bhagwat-rahul/sg13cmos5l_rahulbhagwat_ip_pll_fractional_n_charge_pump_ring_osc/macros/inverter/testbenches/xschem/plot_simulations/figures/inverter_tb_dc_vout.csv

vin | vout | dvout_dvin
0.000000000000000000e+00 | 1.499998240000000038e+00 | -2.000000010049518551e-05
1.000000000000000021e-03 | 1.499998219999999938e+00 | -1.999999994950485416e-05
2.000000000000000042e-03 | 1.499998200000000059e+00 | -1.500000007581547834e-05
3.000000000000000062e-03 | 1.499998189999999898e+00 | -1.499999996212864062e-05
4.000000000000000083e-03 | 1.499998170000000020e+00 | -1.999999994950485416e-05
5.000000000000000104e-03 | 1.499998149999999919e+00 | -2.000000006319169188e-05
6.000000000000000125e-03 | 1.499998130000000041e+00 | -2.000000006319169188e-05
7.000000000000000146e-03 | 1.499998109999999940e+00 | -2.500000005056790542e-05
8.000000000000000167e-03 | 1.499998079999999900e+00 | -2.499999993688106770e-05
8.999999999999999320e-03 | 1.499998060000000022e+00 | -2.000000006319169188e-05
1.000000000000000021e-02 | 1.499998039999999921e+00 | -2.499999993688106770e-05
1.099999999999999936e-02 | 1.499998010000000104e+00 | -2.500000005056790542e-05
1.200000000000000025e-02 | 1.499997990000000003e+00 | -2.499999993688106770e-05
1.299999999999999940e-02 | 1.499997959999999964e+00 | -3.000000015163095668e-05
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
