bhagwat-rahul/sg13cmos5l_rahulbhagwat_ip_pll_fractional_n_charge_pump_ring_osc/final/netlist/slot_13.spice

* Slot13 assembly contract. Existing harness access points; no pad changes.
* reset is active LOW for this project; ibias0 supplies +2 uA into IREF.
* Unused accesses remain isolated. Direct terminals are not the _esd terminals.
.subckt slot_13 vbias
+ dig_in[23] dig_in[22] dig_in[21] dig_in[20] dig_in[19] dig_in[18]
+ dig_in[17] dig_in[16] dig_in[15] dig_in[14] dig_in[13] dig_in[12]
+ dig_in[11] dig_in[10] dig_in[9] dig_in[8] dig_in[7] dig_in[6]
+ dig_in[5] dig_in[4] dig_in[3] dig_in[2] dig_in[1] dig_in[0]
+ dig_out[11] dig_out[10] dig_out[9] dig_out[8] dig_out[7] dig_out[6]
+ dig_out[5] dig_out[4] dig_out[3] dig_out[2] dig_out[1] dig_out[0]
+ ibias0 ibias1 analog_bus3 analog_bus2 analog_bus1 analog_bus0
+ vss_1v2 vdd_1v2 vss_3v3 vdd_3v3 enable clk reset
+ s13_an_0_esd s13_an[0] s13_an_1_esd s13_an[1]
Xpll vdd_1v2 vss_1v2 ibias0 s13_an[0] reset enable
+ dig_in[0] dig_in[1] dig_in[2] dig_in[3] dig_in[4]
+ dig_in[5] dig_in[6] dig_in[7] dig_in[8] dig_in[9]
+ dig_in[10] dig_in[11] s13_an[1] pll_core
.ends slot_13

* Source-derived PLL core LVS reference; no extracted golden cells.
.subckt pll_core VDD VSS IREF ref_clk reset_n enable div_ratio[0] div_ratio[1] div_ratio[2] div_ratio[3] div_ratio[4] div_ratio[5] div_ratio[6] div_ratio[7] div_ratio[8] div_ratio[9] test_div_select[0] test_div_select[1] clk_out
Xanalog VDD up vco_clk down IREF VSS pll_analog
Xdigital VDD VSS ref_clk vco_clk reset_n enable div_ratio[0] div_ratio[1] div_ratio[2] div_ratio[3] div_ratio[4] div_ratio[5] div_ratio[6] div_ratio[7] div_ratio[8] div_ratio[9] test_div_select[0] test_div_select[1] feedback_unused pll_unused clk_out up down pll_digital
.ends pll_core
** sch_path: /foss/designs/current-designs/chipalooza2/sg13cmos5l_rahulbhagwat_ip_pll_fractional_n_charge_pump_ring_osc/layout/core/checks/pll_analog/20261022-053728-417796/schematic/pll_analog.sch
.subckt pll_analog VDD UP VCO_CLK DOWN IREF VSS
*.PININFO UP:I DOWN:I IREF:B VCO_CLK:O VDD:B VSS:B
x_charge_pump VDD UP DOWN IREF VCTRL VSS charge_pump
x_loop_filter VCTRL VSS loop_filter
x_vco VDD VCO_CLK VCTRL VSS ring_oscillator
.ends

* expanding   symbol:  charge_pump.sym # of pins=6
** sym_path: /foss/designs/current-designs/chipalooza2/sg13cmos5l_rahulbhagwat_ip_pll_fractional_n_charge_pump_ring_osc/layout/core/checks/pll_analog/20261022-053728-417796/schematic/charge_pump.sym
** sch_path: /foss/designs/current-designs/chipalooza2/sg13cmos5l_rahulbhagwat_ip_pll_fractional_n_charge_pump_ring_osc/layout/core/checks/pll_analog/20261022-053728-417796/schematic/charge_pump.sch
.subckt charge_pump VDD UP DOWN IREF VCTRL VSS
*.PININFO UP:I DOWN:I IREF:B VCTRL:O VDD:B VSS:B
XM_UP_INV_P UP_B UP VDD VDD sg13_lv_pmos w=0.30u l=0.13u ng=1 m=1
XM_UP_INV_N UP_B UP VSS VSS sg13_lv_nmos w=0.15u l=0.13u ng=1 m=1
XM_IREF IREF IREF VSS VSS sg13_lv_nmos w=4.0u l=0.50u ng=4 m=1
XM_PBIAS PBIAS PBIAS VDD VDD sg13_lv_pmos w=8.0u l=0.50u ng=8 m=1
XM_PBIAS_SINK PBIAS IREF VSS VSS sg13_lv_nmos w=4.0u l=0.50u ng=4 m=1
XM_UP_SOURCE P_UP PBIAS VDD VDD sg13_lv_pmos w=7.0u l=0.50u ng=8 m=1
XM_UP_SWITCH VCTRL UP_B P_UP VDD sg13_lv_pmos w=1.0u l=0.13u ng=1 m=1
XM_DOWN_SWITCH VCTRL DOWN N_DOWN VSS sg13_lv_nmos w=1.5u l=0.13u ng=1 m=1
XM_DOWN_SINK N_DOWN IREF VSS VSS sg13_lv_nmos w=4.0u l=0.50u ng=4 m=1
.ends


* expanding   symbol:  loop_filter.sym # of pins=2
** sym_path: /foss/designs/current-designs/chipalooza2/sg13cmos5l_rahulbhagwat_ip_pll_fractional_n_charge_pump_ring_osc/layout/core/checks/pll_analog/20261022-053728-417796/schematic/loop_filter.sym
** sch_path: /foss/designs/current-designs/chipalooza2/sg13cmos5l_rahulbhagwat_ip_pll_fractional_n_charge_pump_ring_osc/layout/core/checks/pll_analog/20261022-053728-417796/schematic/loop_filter.sch
.subckt loop_filter VCTRL VSS
*.PININFO VCTRL:B VSS:B
XR1 VCTRL FILTER_ZERO VSS rhigh w=1.0u l=22.08u m=1 b=0
XC1A FILTER_ZERO VSS cap_cmomf w=100u l=100u mmin=2 mmax=4 subblock=0 m=1
XC2 VCTRL VSS cap_cmomf w=32.6431u l=32.6431u mmin=2 mmax=4 subblock=0 m=1
**** begin user architecture code



* Simulator model supplied by the PDK LVS setup
* Simulator model supplied by the PDK LVS setup


**** end user architecture code
.ends


* expanding   symbol:  ring_oscillator.sym # of pins=4
** sym_path: /foss/designs/current-designs/chipalooza2/sg13cmos5l_rahulbhagwat_ip_pll_fractional_n_charge_pump_ring_osc/layout/core/checks/pll_analog/20261022-053728-417796/schematic/ring_oscillator.sym
** sch_path: /foss/designs/current-designs/chipalooza2/sg13cmos5l_rahulbhagwat_ip_pll_fractional_n_charge_pump_ring_osc/layout/core/checks/pll_analog/20261022-053728-417796/schematic/ring_oscillator.sch
.subckt ring_oscillator VDD VCO_OUT VCTRL VSS
*.PININFO VCTRL:I VDD:B VSS:B VCO_OUT:O
x1 VDD VBP VCO_CORE net1 VCTRL VSS inverter
x2 VDD VBP net1 net2 VCTRL VSS inverter
x3 VDD VBP net2 VCO_CORE VCTRL VSS inverter
x_bias VDD VBP VCTRL VSS vco_bias
x_buffer VDD VCO_CORE VCO_OUT VSS vco_buffer
.ends


* expanding   symbol:  inverter.sym # of pins=6
** sym_path: /foss/designs/current-designs/chipalooza2/sg13cmos5l_rahulbhagwat_ip_pll_fractional_n_charge_pump_ring_osc/layout/core/checks/pll_analog/20261022-053728-417796/schematic/inverter.sym
** sch_path: /foss/designs/current-designs/chipalooza2/sg13cmos5l_rahulbhagwat_ip_pll_fractional_n_charge_pump_ring_osc/layout/core/checks/pll_analog/20261022-053728-417796/schematic/inverter.sch
.subckt inverter VDD VBP VIN VOUT VBN VSS
*.PININFO VIN:I VBP:I VBN:I VOUT:O VDD:B VSS:B
XM1 net1 VBP VDD VDD sg13_lv_pmos w=18.0u l=0.13u ng=5 m=1
XM2 VOUT VIN net1 VDD sg13_lv_pmos w=3.6u l=0.13u ng=1 m=1
XM3 VOUT VIN net2 VSS sg13_lv_nmos w=3.6u l=0.13u ng=1 m=1
XM4 net2 VBN VSS VSS sg13_lv_nmos w=18.0u l=0.13u ng=5 m=1
.ends


* expanding   symbol:  vco_bias.sym # of pins=4
** sym_path: /foss/designs/current-designs/chipalooza2/sg13cmos5l_rahulbhagwat_ip_pll_fractional_n_charge_pump_ring_osc/layout/core/checks/pll_analog/20261022-053728-417796/schematic/vco_bias.sym
** sch_path: /foss/designs/current-designs/chipalooza2/sg13cmos5l_rahulbhagwat_ip_pll_fractional_n_charge_pump_ring_osc/layout/core/checks/pll_analog/20261022-053728-417796/schematic/vco_bias.sch
.subckt vco_bias VDD VBP VCTRL VSS
*.PININFO VCTRL:I VBP:O VDD:B VSS:B
XM1 VBP VBP VDD VDD sg13_lv_pmos w=0.15u l=0.13u ng=1 m=1
XM2 VBP VCTRL VSS VSS sg13_lv_nmos w=0.15u l=0.13u ng=1 m=1
.ends


* expanding   symbol:  vco_buffer.sym # of pins=4
** sym_path: /foss/designs/current-designs/chipalooza2/sg13cmos5l_rahulbhagwat_ip_pll_fractional_n_charge_pump_ring_osc/layout/core/checks/pll_analog/20261022-053728-417796/schematic/vco_buffer.sym
** sch_path: /foss/designs/current-designs/chipalooza2/sg13cmos5l_rahulbhagwat_ip_pll_fractional_n_charge_pump_ring_osc/layout/core/checks/pll_analog/20261022-053728-417796/schematic/vco_buffer.sch
.subckt vco_buffer VDD VIN VOUT VSS
*.PININFO VIN:I VOUT:O VDD:B VSS:B
XM1 net1 VIN VDD VDD sg13_lv_pmos w=2.40u l=0.13u ng=1 m=1
XM2 net1 VIN VSS VSS sg13_lv_nmos w=1.80u l=0.13u ng=1 m=1
XM3 VOUT net1 VDD VDD sg13_lv_pmos w=1.80u l=0.13u ng=3 m=1
XM4 VOUT net1 VSS VSS sg13_lv_nmos w=0.90u l=0.13u ng=3 m=1
.ends


.subckt pll_digital VDD VSS ref_clk vco_clk reset_n enable div_ratio[0] div_ratio[1] div_ratio[2] div_ratio[3] div_ratio[4] div_ratio[5] div_ratio[6] div_ratio[7] div_ratio[8] div_ratio[9] test_div_select[0] test_div_select[1] feedback_clk pll_clk test_clk up down
* SPICE netlist generated by Yosys 0.68 (git sha1 38e001a6f, Release, GNU /usr/bin/c++ 13.3.0)

X0 VDD VSS sg13cmos5l_decap_8
X1 VDD VSS sg13cmos5l_decap_8
X2 VDD VSS sg13cmos5l_decap_4
X3 VDD VSS sg13cmos5l_decap_8
X4 VDD VSS sg13cmos5l_decap_8
X5 VDD VSS sg13cmos5l_decap_4
X6 VDD VSS sg13cmos5l_decap_8
X7 VDD VSS sg13cmos5l_decap_8
X8 VDD VSS sg13cmos5l_decap_8
X9 VDD VSS sg13cmos5l_decap_8
X10 VDD VSS sg13cmos5l_decap_8
X11 VDD VSS sg13cmos5l_decap_8
X12 VDD VSS sg13cmos5l_decap_8
X13 VDD VSS sg13cmos5l_decap_8
X14 VDD VSS sg13cmos5l_decap_8
X15 VDD VSS sg13cmos5l_fill_2
X16 VDD VSS sg13cmos5l_decap_8
X17 VDD VSS sg13cmos5l_decap_8
X18 VDD VSS sg13cmos5l_fill_1
X19 VDD VSS sg13cmos5l_fill_1
X20 VDD VSS sg13cmos5l_decap_8
X21 VDD VSS sg13cmos5l_decap_8
X22 VDD VSS sg13cmos5l_fill_2
X23 VDD VSS sg13cmos5l_decap_4
X24 VDD VSS sg13cmos5l_decap_8
X25 VDD VSS sg13cmos5l_decap_8
X26 VDD VSS sg13cmos5l_fill_2
X27 VDD VSS sg13cmos5l_fill_1
X28 VDD VSS sg13cmos5l_decap_8
X29 VDD VSS sg13cmos5l_decap_8
X30 VDD VSS sg13cmos5l_decap_4
X31 VDD VSS sg13cmos5l_decap_4
X32 VDD VSS sg13cmos5l_fill_1
X33 VDD VSS sg13cmos5l_fill_1
X34 VDD VSS sg13cmos5l_fill_2
X35 VDD VSS sg13cmos5l_fill_1
X36 VDD VSS sg13cmos5l_decap_4
X37 VDD VSS sg13cmos5l_decap_4
X38 VDD VSS sg13cmos5l_decap_8
X39 VDD VSS sg13cmos5l_decap_4
X40 VDD VSS sg13cmos5l_fill_2
X41 VDD VSS sg13cmos5l_decap_8
X42 VDD VSS sg13cmos5l_decap_8
X43 VDD VSS sg13cmos5l_decap_8
X44 VDD VSS sg13cmos5l_decap_8
X45 VDD VSS sg13cmos5l_decap_4
X46 VDD VSS sg13cmos5l_fill_1
X47 VDD VSS sg13cmos5l_fill_2
X48 VDD VSS sg13cmos5l_fill_2
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
X705 clknet_0_output_divider_i.div4_clk_regs output_divider_i.div4_clk_regs VDD VSS sg13cmos5l_buf_16
X706 clknet_0_output_divider_i.div8_clk output_divider_i.div8_clk VDD VSS sg13cmos5l_buf_16
X707 clknet_0_output_divider_i.div8_clk_regs output_divider_i.div8_clk_regs VDD VSS sg13cmos5l_buf_16
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
