bhagwat-rahul/sg13cmos5l_rahulbhagwat_ip_pll_fractional_n_charge_pump_ring_osc/netlist/layout/sg13cmos5l_chipalooza_analog_project_klayout.cir

* Extracted by KLayout with SG13CMOS5L LVS runset on : 26/08/2026 18:47

.SUBCKT sg13cmos5l_chipalooza_analog_project VAPWR VGND VPWR analog_0 analog_1
+ analog_2 ui_in[0]
X$14 VGND VAPWR analog_2 ui_in[0] inverter
X$15 VGND VAPWR analog_1 analog_0 inverter
M$1 VGND VPWR VGND VGND sg13_lv_pmos L=10u W=10u AS=3.4p AD=3.4p PS=20.68u
+ PD=20.68u rfmode=0
M$2 VGND VAPWR VGND VGND sg13_lv_pmos L=10u W=10u AS=3.4p AD=3.4p PS=20.68u
+ PD=20.68u rfmode=0
.ENDS sg13cmos5l_chipalooza_analog_project

.SUBCKT inverter VSS VDD vout vin
M$1 VSS VSS VSS VSS sg13_lv_nmos L=1u W=2u AS=0.53p AD=0.53p PS=4.06u PD=4.06u
+ rfmode=0
M$2 VSS vin vout VSS sg13_lv_nmos L=1u W=20u AS=3.8p AD=3.8p PS=27.6u PD=27.6u
+ rfmode=0
M$23 VDD VDD VDD VDD sg13_lv_pmos L=1u W=12u AS=3.18p AD=3.18p PS=19.06u
+ PD=19.06u rfmode=0
M$24 VDD vin vout VDD sg13_lv_pmos L=1u W=120u AS=22.8p AD=22.8p PS=127.6u
+ PD=127.6u rfmode=0
.ENDS inverter
