bhagwat-rahul/sg13cmos5l_rahulbhagwat_ip_pll_fractional_n_charge_pump_ring_osc/netlist/pex/sg13cmos5l_chipalooza_analog_project_magic_pex_3.spice

* PEX produced on Wed Aug 26 06:47:14 PM CEST 2026 using /foss/tools/sak/sak-pex.sh with m=3 and s=1 (extresist threshold=10000 mOhm, minres=1000 mOhm, mindelay=1 ps)
* NGSPICE file created from sg13cmos5l_chipalooza_analog_project_pex.ext - technology: ihp-sg13cmos5l

.subckt sg13cmos5l_chipalooza_analog_project_pex VPWR VAPWR VGND rst_n clk ena
+ uio_in[7] uio_in[6] uio_in[5] uio_in[4] uio_in[3] uio_in[2] uio_in[1]
+ uio_in[0] ui_in[7] ui_in[6] ui_in[5] ui_in[4] ui_in[3] ui_in[2] ui_in[1]
+ ui_in[0] uio_oe[7] uio_oe[6] uio_oe[5] uio_oe[4] uio_oe[3] uio_oe[2] uio_oe[1]
+ uio_oe[0] uio_out[7] uio_out[6] uio_out[5] uio_out[4] uio_out[3] uio_out[2]
+ uio_out[1] uio_out[0] uo_out[7] uo_out[6] uo_out[5] uo_out[4] uo_out[3]
+ uo_out[2] uo_out[1] uo_out[0] analog_2 analog_1 analog_0
X0 VAPWR VAPWR VAPWR VAPWR sg13_lv_pmos ad=1.14p pd=6.38u as=0.28875n ps=0.61464m w=6u l=1u
X1 VGND.t55 VGND.t53 VGND.t31 VGND.t54 sg13_lv_nmos ad=0.34p pd=2.68u as=0 ps=0 w=1u l=1u
X2 analog_1 analog_0 VGND.t1 VGND.t0 sg13_lv_nmos ad=0.19p pd=1.38u as=0.19p ps=1.38u w=1u l=1u
X3 analog_1 analog_0 VAPWR VAPWR sg13_lv_pmos ad=1.14p pd=6.38u as=1.14p ps=6.38u w=6u l=1u
X4 VAPWR ui_in[0].t1 analog_2 VAPWR sg13_lv_pmos ad=1.14p pd=6.38u as=1.14p ps=6.38u w=6u l=1u
X5 VAPWR analog_0 analog_1 VAPWR sg13_lv_pmos ad=1.14p pd=6.38u as=1.14p ps=6.38u w=6u l=1u
X6 analog_1 analog_0 VGND.t3 VGND.t4 sg13_lv_nmos ad=0.19p pd=1.38u as=0.19p ps=1.38u w=1u l=1u
X7 VAPWR analog_0 analog_1 VAPWR sg13_lv_pmos ad=1.14p pd=6.38u as=1.14p ps=6.38u w=6u l=1u
X8 VAPWR analog_0 analog_1 VAPWR sg13_lv_pmos ad=1.14p pd=6.38u as=1.14p ps=6.38u w=6u l=1u
X9 VGND.t9 analog_0 analog_1 VGND.t8 sg13_lv_nmos ad=0.19p pd=1.38u as=0.19p ps=1.38u w=1u l=1u
X10 VAPWR analog_0 analog_1 VAPWR sg13_lv_pmos ad=1.14p pd=6.38u as=1.14p ps=6.38u w=6u l=1u
X11 analog_1 analog_0 VAPWR VAPWR sg13_lv_pmos ad=1.14p pd=6.38u as=1.14p ps=6.38u w=6u l=1u
X12 analog_2 ui_in[0].t1 VAPWR VAPWR sg13_lv_pmos ad=1.14p pd=6.38u as=1.14p ps=6.38u w=6u l=1u
X13 VGND.t6 analog_0 analog_1 VGND.t5 sg13_lv_nmos ad=0.19p pd=1.38u as=0.19p ps=1.38u w=1u l=1u
X14 VGND.t12 analog_0 analog_1 VGND.t11 sg13_lv_nmos ad=0.19p pd=1.38u as=0.19p ps=1.38u w=1u l=1u
X15 analog_1 analog_0 VAPWR VAPWR sg13_lv_pmos ad=1.14p pd=6.38u as=1.14p ps=6.38u w=6u l=1u
X16 analog_2 ui_in[0].t1 VAPWR VAPWR sg13_lv_pmos ad=1.14p pd=6.38u as=1.14p ps=6.38u w=6u l=1u
X17 VAPWR analog_0 analog_1 VAPWR sg13_lv_pmos ad=1.14p pd=6.38u as=1.14p ps=6.38u w=6u l=1u
X18 VAPWR ui_in[0].t1 analog_2 VAPWR sg13_lv_pmos ad=1.14p pd=6.38u as=1.14p ps=6.38u w=6u l=1u
X19 VGND.t15 analog_0 analog_1 VGND.t14 sg13_lv_nmos ad=0.19p pd=1.38u as=0.19p ps=1.38u w=1u l=1u
X20 analog_1 analog_0 VGND.t21 VGND.t22 sg13_lv_nmos ad=0.19p pd=1.38u as=0.19p ps=1.38u w=1u l=1u
X21 analog_2 ui_in[0].t1 VAPWR VAPWR sg13_lv_pmos ad=1.14p pd=6.38u as=1.14p ps=6.38u w=6u l=1u
X22 VGND.t50 ui_in[0].t0 analog_2 VGND.t29 sg13_lv_nmos ad=0.19p pd=1.38u as=0.19p ps=1.38u w=1u l=1u
X23 analog_1 analog_0 VGND.t18 VGND.t19 sg13_lv_nmos ad=0.19p pd=1.38u as=0.19p ps=1.38u w=1u l=1u
X24 VAPWR analog_0 analog_1 VAPWR sg13_lv_pmos ad=1.14p pd=6.38u as=1.14p ps=6.38u w=6u l=1u
X25 VAPWR ui_in[0].t1 analog_2 VAPWR sg13_lv_pmos ad=1.14p pd=6.38u as=1.14p ps=6.38u w=6u l=1u
X26 analog_2 ui_in[0].t1 VAPWR VAPWR sg13_lv_pmos ad=1.14p pd=6.38u as=1.14p ps=6.38u w=6u l=1u
X27 analog_2 ui_in[0].t0 VGND.t31 VGND.t0 sg13_lv_nmos ad=0.19p pd=1.38u as=0.19p ps=1.38u w=1u l=1u
X28 VGND.t24 analog_0 analog_1 VGND.t23 sg13_lv_nmos ad=0.19p pd=1.38u as=0.19p ps=1.38u w=1u l=1u
X29 VAPWR VAPWR VAPWR VAPWR sg13_lv_pmos ad=1.14p pd=6.38u as=0 ps=0 w=6u l=1u
X30 analog_2 ui_in[0].t1 VAPWR VAPWR sg13_lv_pmos ad=1.14p pd=6.38u as=1.14p ps=6.38u w=6u l=1u
X31 analog_2 ui_in[0].t1 VAPWR VAPWR sg13_lv_pmos ad=1.14p pd=6.38u as=1.14p ps=6.38u w=6u l=1u
X32 VAPWR VAPWR VAPWR VAPWR sg13_lv_pmos ad=2.04p pd=12.68u as=0 ps=0 w=6u l=1u
X33 VGND.t27 analog_0 analog_1 VGND.t26 sg13_lv_nmos ad=0.19p pd=1.38u as=0.19p ps=1.38u w=1u l=1u
X34 VAPWR analog_0 analog_1 VAPWR sg13_lv_pmos ad=1.14p pd=6.38u as=1.14p ps=6.38u w=6u l=1u
X35 analog_2 ui_in[0].t0 VGND.t32 VGND.t4 sg13_lv_nmos ad=0.19p pd=1.38u as=0.19p ps=1.38u w=1u l=1u
X36 VGND.t30 VGND.t62 VGND.t63 VGND.t57 sg13_lv_nmos ad=0.19p pd=1.38u as=0 ps=0 w=1u l=1u
X37 VGND.t52 VPWR VGND.t52 VGND.t51 sg13_lv_pmos ad=3.4p pd=20.68u as=0 ps=0 w=10u l=10u
X38 VGND.t36 ui_in[0].t0 analog_2 VGND.t8 sg13_lv_nmos ad=0.19p pd=1.38u as=0.19p ps=1.38u w=1u l=1u
X39 VGND.t3 analog_0 analog_1 VGND.t2 sg13_lv_nmos ad=0.19p pd=1.38u as=0.19p ps=1.38u w=1u l=1u
X40 VGND.t34 ui_in[0].t0 analog_2 VGND.t5 sg13_lv_nmos ad=0.19p pd=1.38u as=0.19p ps=1.38u w=1u l=1u
X41 VGND.t38 ui_in[0].t0 analog_2 VGND.t11 sg13_lv_nmos ad=0.19p pd=1.38u as=0.19p ps=1.38u w=1u l=1u
X42 analog_1 analog_0 VAPWR VAPWR sg13_lv_pmos ad=1.14p pd=6.38u as=1.14p ps=6.38u w=6u l=1u
X43 analog_1 analog_0 VAPWR VAPWR sg13_lv_pmos ad=1.14p pd=6.38u as=1.14p ps=6.38u w=6u l=1u
X44 VGND.t40 ui_in[0].t0 analog_2 VGND.t14 sg13_lv_nmos ad=0.19p pd=1.38u as=0.19p ps=1.38u w=1u l=1u
X45 analog_2 ui_in[0].t0 VGND.t44 VGND.t22 sg13_lv_nmos ad=0.19p pd=1.38u as=0.19p ps=1.38u w=1u l=1u
X46 analog_1 analog_0 VGND.t9 VGND.t10 sg13_lv_nmos ad=0.19p pd=1.38u as=0.19p ps=1.38u w=1u l=1u
X47 VAPWR analog_0 analog_1 VAPWR sg13_lv_pmos ad=1.14p pd=6.38u as=1.14p ps=6.38u w=6u l=1u
X48 analog_2 ui_in[0].t0 VGND.t42 VGND.t19 sg13_lv_nmos ad=0.19p pd=1.38u as=0.19p ps=1.38u w=1u l=1u
X49 analog_1 analog_0 VAPWR VAPWR sg13_lv_pmos ad=1.14p pd=6.38u as=1.14p ps=6.38u w=6u l=1u
X50 VGND.t46 ui_in[0].t0 analog_2 VGND.t23 sg13_lv_nmos ad=0.19p pd=1.38u as=0.19p ps=1.38u w=1u l=1u
X51 analog_1 analog_0 VGND.t12 VGND.t13 sg13_lv_nmos ad=0.19p pd=1.38u as=0.19p ps=1.38u w=1u l=1u
X52 VAPWR analog_0 analog_1 VAPWR sg13_lv_pmos ad=1.14p pd=6.38u as=1.14p ps=6.38u w=6u l=1u
X53 analog_1 analog_0 VAPWR VAPWR sg13_lv_pmos ad=1.14p pd=6.38u as=1.14p ps=6.38u w=6u l=1u
X54 VAPWR ui_in[0].t1 analog_2 VAPWR sg13_lv_pmos ad=1.14p pd=6.38u as=1.14p ps=6.38u w=6u l=1u
X55 VGND.t18 analog_0 analog_1 VGND.t17 sg13_lv_nmos ad=0.19p pd=1.38u as=0.19p ps=1.38u w=1u l=1u
X56 analog_1 analog_0 VAPWR VAPWR sg13_lv_pmos ad=1.14p pd=6.38u as=1.14p ps=6.38u w=6u l=1u
X57 analog_1 analog_0 VAPWR VAPWR sg13_lv_pmos ad=1.14p pd=6.38u as=1.14p ps=6.38u w=6u l=1u
X58 analog_2 ui_in[0].t1 VAPWR VAPWR sg13_lv_pmos ad=1.14p pd=6.38u as=1.14p ps=6.38u w=6u l=1u
X59 VGND.t48 ui_in[0].t0 analog_2 VGND.t26 sg13_lv_nmos ad=0.19p pd=1.38u as=0.19p ps=1.38u w=1u l=1u
X60 analog_1 analog_0 VGND.t15 VGND.t16 sg13_lv_nmos ad=0.19p pd=1.38u as=0.19p ps=1.38u w=1u l=1u
X61 VAPWR VAPWR VAPWR VAPWR sg13_lv_pmos ad=2.04p pd=12.68u as=0 ps=0 w=6u l=1u
X62 VGND.t50 VGND.t56 VGND.t58 VGND.t57 sg13_lv_nmos ad=0.19p pd=1.38u as=0 ps=0 w=1u l=1u
X63 VGND.t21 analog_0 analog_1 VGND.t20 sg13_lv_nmos ad=0.19p pd=1.38u as=0.19p ps=1.38u w=1u l=1u
X64 analog_1 analog_0 VGND.t27 VGND.t28 sg13_lv_nmos ad=0.19p pd=1.38u as=0.19p ps=1.38u w=1u l=1u
X65 VGND.t61 VGND.t59 VGND.t1 VGND.t54 sg13_lv_nmos ad=0.34p pd=2.68u as=0 ps=0 w=1u l=1u
X66 analog_1 analog_0 VGND.t6 VGND.t7 sg13_lv_nmos ad=0.19p pd=1.38u as=0.19p ps=1.38u w=1u l=1u
X67 analog_1 analog_0 VGND.t24 VGND.t25 sg13_lv_nmos ad=0.19p pd=1.38u as=0.19p ps=1.38u w=1u l=1u
X68 analog_2 ui_in[0].t1 VAPWR VAPWR sg13_lv_pmos ad=1.14p pd=6.38u as=1.14p ps=6.38u w=6u l=1u
X69 VAPWR ui_in[0].t1 analog_2 VAPWR sg13_lv_pmos ad=1.14p pd=6.38u as=1.14p ps=6.38u w=6u l=1u
X70 VGND.t32 ui_in[0].t0 analog_2 VGND.t2 sg13_lv_nmos ad=0.19p pd=1.38u as=0.19p ps=1.38u w=1u l=1u
X71 VAPWR ui_in[0].t1 analog_2 VAPWR sg13_lv_pmos ad=1.14p pd=6.38u as=1.14p ps=6.38u w=6u l=1u
X72 VAPWR ui_in[0].t1 analog_2 VAPWR sg13_lv_pmos ad=1.14p pd=6.38u as=1.14p ps=6.38u w=6u l=1u
X73 analog_2 ui_in[0].t0 VGND.t36 VGND.t10 sg13_lv_nmos ad=0.19p pd=1.38u as=0.19p ps=1.38u w=1u l=1u
X74 VAPWR ui_in[0].t1 analog_2 VAPWR sg13_lv_pmos ad=1.14p pd=6.38u as=1.14p ps=6.38u w=6u l=1u
X75 analog_2 ui_in[0].t1 VAPWR VAPWR sg13_lv_pmos ad=1.14p pd=6.38u as=1.14p ps=6.38u w=6u l=1u
X76 analog_2 ui_in[0].t0 VGND.t38 VGND.t13 sg13_lv_nmos ad=0.19p pd=1.38u as=0.19p ps=1.38u w=1u l=1u
X77 analog_2 ui_in[0].t1 VAPWR VAPWR sg13_lv_pmos ad=1.14p pd=6.38u as=1.14p ps=6.38u w=6u l=1u
X78 VGND.t42 ui_in[0].t0 analog_2 VGND.t17 sg13_lv_nmos ad=0.19p pd=1.38u as=0.19p ps=1.38u w=1u l=1u
X79 VAPWR analog_0 analog_1 VAPWR sg13_lv_pmos ad=1.14p pd=6.38u as=1.14p ps=6.38u w=6u l=1u
X80 VAPWR ui_in[0].t1 analog_2 VAPWR sg13_lv_pmos ad=1.14p pd=6.38u as=1.14p ps=6.38u w=6u l=1u
X81 analog_2 ui_in[0].t0 VGND.t40 VGND.t16 sg13_lv_nmos ad=0.19p pd=1.38u as=0.19p ps=1.38u w=1u l=1u
X82 analog_1 analog_0 VAPWR VAPWR sg13_lv_pmos ad=1.14p pd=6.38u as=1.14p ps=6.38u w=6u l=1u
X83 VGND.t44 ui_in[0].t0 analog_2 VGND.t20 sg13_lv_nmos ad=0.19p pd=1.38u as=0.19p ps=1.38u w=1u l=1u
X84 analog_2 ui_in[0].t0 VGND.t48 VGND.t28 sg13_lv_nmos ad=0.19p pd=1.38u as=0.19p ps=1.38u w=1u l=1u
X85 VGND.t65 VAPWR VGND.t65 VGND.t64 sg13_lv_pmos ad=3.4p pd=20.68u as=0 ps=0 w=10u l=10u
X86 VAPWR ui_in[0].t1 analog_2 VAPWR sg13_lv_pmos ad=1.14p pd=6.38u as=1.14p ps=6.38u w=6u l=1u
X87 analog_2 ui_in[0].t0 VGND.t34 VGND.t7 sg13_lv_nmos ad=0.19p pd=1.38u as=0.19p ps=1.38u w=1u l=1u
X88 analog_2 ui_in[0].t0 VGND.t46 VGND.t25 sg13_lv_nmos ad=0.19p pd=1.38u as=0.19p ps=1.38u w=1u l=1u
X89 VGND.t30 analog_0 analog_1 VGND.t29 sg13_lv_nmos ad=0.19p pd=1.38u as=0.19p ps=1.38u w=1u l=1u
R0 ui_in[0].n15 ui_in[0].t1 0.994683
R1 ui_in[0].n17 ui_in[0].t0 0.994013
R2 ui_in[0].n9 ui_in[0].n1 0.748572
R3 ui_in[0].n10 ui_in[0].n9 0.578786
R4 ui_in[0].n11 ui_in[0].n10 0.578786
R5 ui_in[0].n12 ui_in[0].n11 0.578786
R6 ui_in[0].n13 ui_in[0].n12 0.578786
R7 ui_in[0].n14 ui_in[0].n13 0.578786
R8 ui_in[0].n15 ui_in[0].n14 0.578786
R9 ui_in[0].n0 ui_in[0].n24 0.755676
R10 ui_in[0].n24 ui_in[0].n23 0.578786
R11 ui_in[0].n23 ui_in[0].n22 0.578786
R12 ui_in[0].n22 ui_in[0].n21 0.578786
R13 ui_in[0].n21 ui_in[0].n20 0.578786
R14 ui_in[0].n20 ui_in[0].n19 0.578786
R15 ui_in[0].n19 ui_in[0].n18 0.578786
R16 ui_in[0].n18 ui_in[0].n17 0.578786
R17 ui_in[0].n14 ui_in[0].n8 0.254024
R18 ui_in[0].n13 ui_in[0].n7 0.254024
R19 ui_in[0].n12 ui_in[0].n6 0.254024
R20 ui_in[0].n11 ui_in[0].n5 0.254024
R21 ui_in[0].n10 ui_in[0].n4 0.254024
R22 ui_in[0].n9 ui_in[0].n3 0.254024
R23 ui_in[0].n1 ui_in[0].n2 0.0282822
R24 ui_in[0].n24 ui_in[0].n2 0.254024
R25 ui_in[0].n23 ui_in[0].n3 0.254024
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
C54 VGND.t52 VGND 43.632f
C55 VGND.t1 VGND 11.71255f
C56 VGND.t50 VGND 3.09716f
C57 ui_in[0].n0 VGND 4.027f
C58 ui_in[0].n1 VGND 0.12143f
C59 ui_in[0].n2 VGND 0.23471f
C60 ui_in[0].n3 VGND 0.23471f
C61 ui_in[0].n4 VGND 0.23471f
C62 ui_in[0].n5 VGND 0.23471f
C63 ui_in[0].n6 VGND 0.23471f
C64 ui_in[0].n7 VGND 0.23471f
C65 ui_in[0].n8 VGND 0.24805f
C66 ui_in[0].n9 VGND 0.07136f
C67 ui_in[0].n10 VGND 0.05503f
C68 ui_in[0].n11 VGND 0.05503f
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
