bhagwat-rahul/sg13cmos5l_rahulbhagwat_ip_pll_fractional_n_charge_pump_ring_osc/macros/pll_digital/frozen/v1/spice/pll_digital.spice

* NGSPICE file created from pll_digital.ext - technology: ihp-sg13cmos5l

* Black-box entry subcircuit for sg13cmos5l_decap_4 abstract view
.subckt sg13cmos5l_decap_4 VDD VSS
.ends

* Black-box entry subcircuit for sg13cmos5l_fill_1 abstract view
.subckt sg13cmos5l_fill_1 VDD VSS
.ends

* Black-box entry subcircuit for sg13cmos5l_decap_8 abstract view
.subckt sg13cmos5l_decap_8 VDD VSS
.ends

* Black-box entry subcircuit for sg13cmos5l_a21oi_1 abstract view
.subckt sg13cmos5l_a21oi_1 Y A1 A2 B1 VDD VSS
.ends

* Black-box entry subcircuit for sg13cmos5l_a22oi_1 abstract view
.subckt sg13cmos5l_a22oi_1 Y A1 A2 B1 B2 VDD VSS
.ends

* Black-box entry subcircuit for sg13cmos5l_fill_2 abstract view
.subckt sg13cmos5l_fill_2 VDD VSS
.ends

* Black-box entry subcircuit for sg13cmos5l_buf_8 abstract view
.subckt sg13cmos5l_buf_8 X A VDD VSS
.ends

* Black-box entry subcircuit for sg13cmos5l_nor4_1 abstract view
.subckt sg13cmos5l_nor4_1 Y A B C D VDD VSS
.ends

* Black-box entry subcircuit for sg13cmos5l_inv_4 abstract view
.subckt sg13cmos5l_inv_4 Y A VDD VSS
.ends

* Black-box entry subcircuit for sg13cmos5l_nand3_1 abstract view
.subckt sg13cmos5l_nand3_1 Y A B C VDD VSS
.ends

* Black-box entry subcircuit for sg13cmos5l_dfrbpq_2 abstract view
.subckt sg13cmos5l_dfrbpq_2 Q CLK D RESET_B VDD VSS
.ends

* Black-box entry subcircuit for sg13cmos5l_o21ai_1 abstract view
.subckt sg13cmos5l_o21ai_1 Y A1 A2 B1 VDD VSS
.ends

* Black-box entry subcircuit for sg13cmos5l_inv_2 abstract view
.subckt sg13cmos5l_inv_2 Y A VDD VSS
.ends

* Black-box entry subcircuit for sg13cmos5l_nand2_1 abstract view
.subckt sg13cmos5l_nand2_1 Y A B VDD VSS
.ends

* Black-box entry subcircuit for sg13cmos5l_buf_16 abstract view
.subckt sg13cmos5l_buf_16 X A VDD VSS
.ends

* Black-box entry subcircuit for sg13cmos5l_nand2b_1 abstract view
.subckt sg13cmos5l_nand2b_1 Y A_N B VDD VSS
.ends

* Black-box entry subcircuit for sg13cmos5l_nor2b_1 abstract view
.subckt sg13cmos5l_nor2b_1 Y A B_N VDD VSS
.ends

* Black-box entry subcircuit for sg13cmos5l_dfrbp_2 abstract view
.subckt sg13cmos5l_dfrbp_2 Q Q_N CLK D RESET_B VDD VSS
.ends

* Black-box entry subcircuit for sg13cmos5l_inv_16 abstract view
.subckt sg13cmos5l_inv_16 Y A VDD VSS
.ends

* Black-box entry subcircuit for sg13cmos5l_nor2_1 abstract view
.subckt sg13cmos5l_nor2_1 Y A B VDD VSS
.ends

* Black-box entry subcircuit for sg13cmos5l_buf_2 abstract view
.subckt sg13cmos5l_buf_2 X A VDD VSS
.ends

* Black-box entry subcircuit for sg13cmos5l_nor3_1 abstract view
.subckt sg13cmos5l_nor3_1 Y A B C VDD VSS
.ends

* Black-box entry subcircuit for sg13cmos5l_buf_1 abstract view
.subckt sg13cmos5l_buf_1 X A VDD VSS
.ends

* Black-box entry subcircuit for sg13cmos5l_nand4_1 abstract view
.subckt sg13cmos5l_nand4_1 Y A B C D VDD VSS
.ends

* Black-box entry subcircuit for sg13cmos5l_and2_2 abstract view
.subckt sg13cmos5l_and2_2 X A B VDD VSS
.ends

* Black-box entry subcircuit for sg13cmos5l_and4_1 abstract view
.subckt sg13cmos5l_and4_1 X A B C D VDD VSS
.ends

* Black-box entry subcircuit for sg13cmos5l_tielo abstract view
.subckt sg13cmos5l_tielo L_LO VDD VSS
.ends

* Black-box entry subcircuit for sg13cmos5l_and2_1 abstract view
.subckt sg13cmos5l_and2_1 X A B VDD VSS
.ends

* Black-box entry subcircuit for sg13cmos5l_nand2b_2 abstract view
.subckt sg13cmos5l_nand2b_2 Y A_N B VDD VSS
.ends

* Black-box entry subcircuit for sg13cmos5l_a221oi_1 abstract view
.subckt sg13cmos5l_a221oi_1 Y A1 A2 B1 B2 C1 VDD VSS
.ends

* Black-box entry subcircuit for sg13cmos5l_mux4_1 abstract view
.subckt sg13cmos5l_mux4_1 X A0 A1 A2 A3 S0 S1 VDD VSS
.ends

* Black-box entry subcircuit for sg13cmos5l_tiehi abstract view
.subckt sg13cmos5l_tiehi L_HI VDD VSS
.ends

* Black-box entry subcircuit for sg13cmos5l_nand3b_1 abstract view
.subckt sg13cmos5l_nand3b_1 Y A_N B C VDD VSS
.ends

* Black-box entry subcircuit for sg13cmos5l_or2_1 abstract view
.subckt sg13cmos5l_or2_1 X A B VDD VSS
.ends

.subckt pll_digital VDD VSS div_ratio[0] div_ratio[1] div_ratio[2] div_ratio[3] div_ratio[4]
+ div_ratio[5] div_ratio[6] div_ratio[7] div_ratio[8] div_ratio[9] down enable feedback_clk
+ pll_clk ref_clk reset_n test_clk test_div_select[0] test_div_select[1] up vco_clk
XFILLER_7_7 VDD VSS sg13cmos5l_decap_4
XFILLER_13_155 VDD VSS sg13cmos5l_fill_1
XFILLER_3_78 VDD VSS sg13cmos5l_decap_8
Xfeedback_divider_i._418_ feedback_divider_i._418_/Y feedback_divider_i._498_/Q feedback_divider_i._291_/A
+ feedback_divider_i._537_/Q VDD VSS sg13cmos5l_a21oi_1
XFILLER_8_170 VDD VSS sg13cmos5l_decap_8
XFILLER_8_181 VDD VSS sg13cmos5l_fill_1
Xfeedback_divider_i._349_ feedback_divider_i._349_/Y feedback_divider_i._574_/Q feedback_divider_i._585_/Q
+ feedback_divider_i._584_/Q feedback_divider_i._573_/Q VDD VSS sg13cmos5l_a22oi_1
XFILLER_18_203 VDD VSS sg13cmos5l_decap_4
XFILLER_18_247 VDD VSS sg13cmos5l_fill_2
XFILLER_2_302 VDD VSS sg13cmos5l_decap_8
Xclkbuf_2_2_0_pll_clk_regs clkbuf_3_5_0_pll_clk_regs/A clkbuf_2_3_0_pll_clk_regs/A
+ VDD VSS sg13cmos5l_buf_8
Xfeedback_divider_i.configuration_decode_i._141_ feedback_divider_i._309_/A fanout55/X
+ fanout13/X fanout53/X feedback_divider_i.configuration_decode_i._141_/D VDD VSS
+ sg13cmos5l_nor4_1
Xoutput_divider_i.vco_input_buffer.input_inverter_72 output_divider_i.vco_input_buffer.input_inverter_72/Y
+ vco_clk VDD VSS sg13cmos5l_inv_4
Xfeedback_divider_i.configuration_decode_i._072_ feedback_divider_i._261_/A feedback_divider_i.configuration_decode_i._072_/A
+ fanout20/X feedback_divider_i.configuration_decode_i._072_/C VDD VSS sg13cmos5l_nand3_1
XFILLER_17_280 VDD VSS sg13cmos5l_fill_1
XFILLER_24_239 VDD VSS sg13cmos5l_fill_2
XFILLER_15_206 VDD VSS sg13cmos5l_decap_8
XFILLER_23_283 VDD VSS sg13cmos5l_fill_1
XFILLER_23_53 VDD VSS sg13cmos5l_decap_8
Xfeedback_divider_i.configuration_decode_i._124_ feedback_divider_i._294_/A fanout45/X
+ fanout51/X feedback_divider_i.configuration_decode_i._146_/A fanout14/X VDD VSS
+ sg13cmos5l_nor4_1
Xfeedback_divider_i.configuration_decode_i._055_ feedback_divider_i.configuration_decode_i._055_/Y
+ fanout62/X input3/X fanout59/X fanout57/X VDD VSS sg13cmos5l_a22oi_1
XFILLER_0_35 VDD VSS sg13cmos5l_decap_4
XFILLER_14_294 VDD VSS sg13cmos5l_decap_8
XFILLER_17_9 VDD VSS sg13cmos5l_fill_2
XFILLER_2_132 VDD VSS sg13cmos5l_fill_1
XFILLER_11_220 VDD VSS sg13cmos5l_fill_2
XFILLER_11_253 VDD VSS sg13cmos5l_fill_1
XFILLER_18_42 VDD VSS sg13cmos5l_fill_1
XFILLER_22_7 VDD VSS sg13cmos5l_decap_8
Xclkbuf_4_5_0_pll_clk_regs clkbuf_4_5_0_pll_clk_regs/X clkbuf_4_5_0_pll_clk_regs/A
+ VDD VSS sg13cmos5l_buf_8
Xfeedback_divider_i.configuration_decode_i._107_ feedback_divider_i._279_/A fanout46/X
+ fanout52/X feedback_divider_i.configuration_decode_i._147_/A fanout16/X VDD VSS
+ sg13cmos5l_nor4_1
Xfeedback_divider_i._597_ feedback_clk feedback_divider_i._597_/CLK feedback_divider_i._597_/D
+ fanout33/X VDD VSS sg13cmos5l_dfrbpq_2
XFILLER_20_87 VDD VSS sg13cmos5l_decap_4
XFILLER_4_205 VDD VSS sg13cmos5l_fill_1
Xfeedback_divider_i._520_ feedback_divider_i._520_/Q clkbuf_4_2_0_pll_clk_regs/X feedback_divider_i._520_/D
+ fanout23/X VDD VSS sg13cmos5l_dfrbpq_2
Xfeedback_divider_i._451_ feedback_divider_i._522_/D feedback_divider_i._493_/Q feedback_divider_i._308_/Y
+ feedback_divider_i._450_/Y VDD VSS sg13cmos5l_o21ai_1
Xfeedback_divider_i._382_ feedback_divider_i._382_/Y feedback_divider_i._502_/Q feedback_divider_i._273_/A
+ feedback_divider_i._555_/Q VDD VSS sg13cmos5l_a21oi_1
XFILLER_25_153 VDD VSS sg13cmos5l_fill_1
XFILLER_25_197 VDD VSS sg13cmos5l_decap_8
XFILLER_9_308 VDD VSS sg13cmos5l_fill_1
XFILLER_0_230 VDD VSS sg13cmos5l_decap_8
XFILLER_16_142 VDD VSS sg13cmos5l_fill_1
Xfeedback_divider_i._296_ feedback_divider_i._296_/Y feedback_divider_i._296_/A VDD
+ VSS sg13cmos5l_inv_2
Xfeedback_divider_i._503_ feedback_divider_i._503_/Q feedback_divider_i._561_/CLK
+ feedback_divider_i._503_/D fanout35/X VDD VSS sg13cmos5l_dfrbpq_2
Xfeedback_divider_i._434_ feedback_divider_i._434_/Y feedback_divider_i._496_/Q feedback_divider_i._299_/A
+ feedback_divider_i._529_/Q VDD VSS sg13cmos5l_a21oi_1
Xfeedback_divider_i._365_ feedback_divider_i._565_/D feedback_divider_i._503_/Q feedback_divider_i._265_/Y
+ feedback_divider_i._364_/Y VDD VSS sg13cmos5l_o21ai_1
XFILLER_22_178 VDD VSS sg13cmos5l_decap_4
Xfeedback_divider_i._279_ feedback_divider_i._279_/Y feedback_divider_i._279_/A VDD
+ VSS sg13cmos5l_inv_2
Xfeedback_divider_i._348_ feedback_divider_i._586_/D feedback_divider_i._572_/Q feedback_divider_i._256_/Y
+ feedback_divider_i._347_/Y VDD VSS sg13cmos5l_o21ai_1
Xfeedback_divider_i._417_ feedback_divider_i._539_/D feedback_divider_i._497_/Q feedback_divider_i._291_/Y
+ feedback_divider_i._416_/Y VDD VSS sg13cmos5l_o21ai_1
XFILLER_10_137 VDD VSS sg13cmos5l_decap_8
XFILLER_12_55 VDD VSS sg13cmos5l_fill_1
XFILLER_12_77 VDD VSS sg13cmos5l_fill_1
Xfeedback_divider_i.configuration_decode_i._140_ fanout13/A fanout60/X fanout40/X
+ VDD VSS sg13cmos5l_nand2_1
Xfeedback_divider_i.configuration_decode_i._071_ feedback_divider_i._260_/A feedback_divider_i.configuration_decode_i._072_/A
+ fanout20/X feedback_divider_i.configuration_decode_i._072_/C VDD VSS sg13cmos5l_a21oi_1
XFILLER_15_229 VDD VSS sg13cmos5l_decap_4
XFILLER_23_32 VDD VSS sg13cmos5l_fill_1
XFILLER_0_14 VDD VSS sg13cmos5l_decap_8
XFILLER_14_273 VDD VSS sg13cmos5l_decap_8
XFILLER_2_100 VDD VSS sg13cmos5l_fill_1
XFILLER_2_188 VDD VSS sg13cmos5l_decap_8
XFILLER_9_56 VDD VSS sg13cmos5l_decap_4
Xclkbuf_4_13_0_pll_clk_regs feedback_divider_i._588_/CLK clkbuf_3_6_0_pll_clk_regs/X
+ VDD VSS sg13cmos5l_buf_8
Xfeedback_divider_i.configuration_decode_i._123_ feedback_divider_i._293_/A fanout56/X
+ fanout14/X fanout54/X feedback_divider_i.configuration_decode_i._141_/D VDD VSS
+ sg13cmos5l_nor4_1
Xfeedback_divider_i.configuration_decode_i._054_ feedback_divider_i.configuration_decode_i._054_/Y
+ fanout62/X fanout58/X VDD VSS sg13cmos5l_nand2_1
XFILLER_20_232 VDD VSS sg13cmos5l_decap_4
XFILLER_20_265 VDD VSS sg13cmos5l_fill_1
XFILLER_11_232 VDD VSS sg13cmos5l_decap_8
XFILLER_11_243 VDD VSS sg13cmos5l_fill_1
Xclkbuf_0_output_divider_i.div4_clk_regs clkbuf_0_output_divider_i.div4_clk_regs/X
+ clkbuf_regs_1_div4/X VDD VSS sg13cmos5l_buf_16
Xfeedback_divider_i.configuration_decode_i._106_ feedback_divider_i._278_/A fanout46/X
+ fanout52/X feedback_divider_i.configuration_decode_i._146_/A fanout16/X VDD VSS
+ sg13cmos5l_nor4_1
Xfeedback_divider_i._596_ feedback_divider_i._596_/Q clkbuf_4_4_0_pll_clk_regs/X feedback_divider_i._596_/D
+ fanout24/X VDD VSS sg13cmos5l_dfrbpq_2
Xfeedback_divider_i._450_ feedback_divider_i._450_/Y feedback_divider_i._494_/Q feedback_divider_i._307_/A
+ feedback_divider_i._521_/Q VDD VSS sg13cmos5l_a21oi_1
Xfeedback_divider_i._381_ feedback_divider_i._557_/D feedback_divider_i._501_/Q feedback_divider_i._273_/Y
+ feedback_divider_i._380_/Y VDD VSS sg13cmos5l_o21ai_1
XFILLER_19_140 VDD VSS sg13cmos5l_fill_1
XFILLER_6_35 VDD VSS sg13cmos5l_decap_8
Xfeedback_divider_i._579_ feedback_divider_i._579_/Q clkbuf_4_4_0_pll_clk_regs/X feedback_divider_i._579_/D
+ fanout24/X VDD VSS sg13cmos5l_dfrbpq_2
XFILLER_25_132 VDD VSS sg13cmos5l_decap_8
XFILLER_15_88 VDD VSS sg13cmos5l_fill_2
Xfeedback_divider_i._295_ feedback_divider_i._295_/Y feedback_divider_i._295_/A VDD
+ VSS sg13cmos5l_inv_2
Xfeedback_divider_i._502_ feedback_divider_i._502_/Q clkbuf_4_4_0_pll_clk_regs/X feedback_divider_i._504_/D
+ fanout24/X VDD VSS sg13cmos5l_dfrbpq_2
Xfeedback_divider_i._433_ feedback_divider_i._531_/D feedback_divider_i._495_/Q feedback_divider_i._299_/Y
+ feedback_divider_i._432_/Y VDD VSS sg13cmos5l_o21ai_1
Xfeedback_divider_i._364_ feedback_divider_i._364_/Y feedback_divider_i._504_/Q feedback_divider_i._264_/A
+ feedback_divider_i._564_/Q VDD VSS sg13cmos5l_a21oi_1
XFILLER_22_113 VDD VSS sg13cmos5l_decap_4
XFILLER_26_87 VDD VSS sg13cmos5l_fill_1
XFILLER_3_14 VDD VSS sg13cmos5l_decap_8
XFILLER_3_25 VDD VSS sg13cmos5l_fill_2
XFILLER_8_194 VDD VSS sg13cmos5l_decap_8
Xfeedback_divider_i._278_ feedback_divider_i._278_/Y feedback_divider_i._278_/A VDD
+ VSS sg13cmos5l_inv_2
Xfeedback_divider_i._347_ feedback_divider_i._347_/Y feedback_divider_i._574_/Q feedback_divider_i._586_/Q
+ feedback_divider_i._585_/Q feedback_divider_i._573_/Q VDD VSS sg13cmos5l_a22oi_1
Xfeedback_divider_i._416_ feedback_divider_i._416_/Y feedback_divider_i._498_/Q feedback_divider_i._290_/A
+ feedback_divider_i._538_/Q VDD VSS sg13cmos5l_a21oi_1
Xfeedback_divider_i.configuration_decode_i._070_ feedback_divider_i._259_/A feedback_divider_i.configuration_decode_i._066_/Y
+ fanout63/X feedback_divider_i.configuration_decode_i._044_/A feedback_divider_i.configuration_decode_i._049_/Y
+ VDD VSS sg13cmos5l_a22oi_1
XFILLER_24_219 VDD VSS sg13cmos5l_decap_8
XFILLER_2_145 VDD VSS sg13cmos5l_fill_1
XFILLER_9_35 VDD VSS sg13cmos5l_fill_1
Xfeedback_divider_i.configuration_decode_i._122_ fanout15/A input9/X input10/X VDD
+ VSS sg13cmos5l_nand2b_1
Xfeedback_divider_i.configuration_decode_i._053_ feedback_divider_i._249_/A feedback_divider_i.configuration_decode_i._072_/C
+ feedback_divider_i.configuration_decode_i._051_/Y feedback_divider_i.configuration_decode_i._047_/Y
+ fanout62/X VDD VSS sg13cmos5l_a22oi_1
XFILLER_11_222 VDD VSS sg13cmos5l_fill_1
XFILLER_7_215 VDD VSS sg13cmos5l_fill_2
Xclkbuf_regs_2_div8 clkbuf_regs_2_div8/X clkbuf_regs_2_div8/A VDD VSS sg13cmos5l_buf_16
Xfeedback_divider_i.configuration_decode_i._105_ feedback_divider_i._277_/A input5/X
+ fanout16/X input6/X feedback_divider_i.configuration_decode_i._141_/D VDD VSS sg13cmos5l_nor4_1
XFILLER_1_0 VDD VSS sg13cmos5l_decap_8
Xfeedback_divider_i._595_ feedback_divider_i._595_/Q clkbuf_4_6_0_pll_clk_regs/X feedback_divider_i._595_/D
+ fanout25/X VDD VSS sg13cmos5l_dfrbpq_2
XFILLER_4_229 VDD VSS sg13cmos5l_decap_8
XFILLER_28_163 VDD VSS sg13cmos5l_decap_4
XFILLER_3_240 VDD VSS sg13cmos5l_decap_4
XFILLER_3_262 VDD VSS sg13cmos5l_decap_8
XFILLER_6_14 VDD VSS sg13cmos5l_fill_2
Xfeedback_divider_i._380_ feedback_divider_i._380_/Y feedback_divider_i._502_/Q feedback_divider_i._272_/A
+ feedback_divider_i._556_/Q VDD VSS sg13cmos5l_a21oi_1
XFILLER_19_152 VDD VSS sg13cmos5l_decap_8
Xclkbuf_4_1_0_pll_clk_regs clkbuf_4_1_0_pll_clk_regs/X clkbuf_4_1_0_pll_clk_regs/A
+ VDD VSS sg13cmos5l_buf_8
Xfeedback_divider_i._578_ feedback_divider_i._578_/Q clkbuf_4_4_0_pll_clk_regs/X feedback_divider_i._578_/D
+ fanout24/X VDD VSS sg13cmos5l_dfrbpq_2
XFILLER_0_265 VDD VSS sg13cmos5l_fill_1
XFILLER_16_100 VDD VSS sg13cmos5l_fill_2
XFILLER_16_122 VDD VSS sg13cmos5l_fill_2
XFILLER_16_155 VDD VSS sg13cmos5l_fill_2
Xfeedback_divider_i._294_ feedback_divider_i._294_/Y feedback_divider_i._294_/A VDD
+ VSS sg13cmos5l_inv_2
Xfeedback_divider_i._501_ feedback_divider_i._501_/Q clkbuf_4_4_0_pll_clk_regs/X feedback_divider_i._503_/D
+ fanout24/X VDD VSS sg13cmos5l_dfrbpq_2
Xfeedback_divider_i._432_ feedback_divider_i._432_/Y feedback_divider_i._496_/Q feedback_divider_i._298_/A
+ feedback_divider_i._530_/Q VDD VSS sg13cmos5l_a21oi_1
Xfeedback_divider_i._363_ feedback_divider_i._566_/D feedback_divider_i._503_/Q feedback_divider_i._264_/Y
+ feedback_divider_i._362_/Y VDD VSS sg13cmos5l_o21ai_1
Xclkbuf_3_7_0_pll_clk_regs clkbuf_3_7_0_pll_clk_regs/X clkbuf_3_7_0_pll_clk_regs/A
+ VDD VSS sg13cmos5l_buf_8
XFILLER_26_44 VDD VSS sg13cmos5l_fill_2
XFILLER_9_118 VDD VSS sg13cmos5l_fill_1
Xfeedback_divider_i._277_ feedback_divider_i._277_/Y feedback_divider_i._277_/A VDD
+ VSS sg13cmos5l_inv_2
Xfeedback_divider_i._346_ feedback_divider_i._587_/D feedback_divider_i._572_/Q feedback_divider_i._255_/Y
+ feedback_divider_i._345_/Y VDD VSS sg13cmos5l_o21ai_1
Xfeedback_divider_i._415_ feedback_divider_i._540_/D feedback_divider_i._497_/Q feedback_divider_i._290_/Y
+ feedback_divider_i._414_/Y VDD VSS sg13cmos5l_o21ai_1
XFILLER_12_68 VDD VSS sg13cmos5l_decap_8
XFILLER_5_7 VDD VSS sg13cmos5l_decap_8
XFILLER_5_132 VDD VSS sg13cmos5l_decap_8
XFILLER_5_187 VDD VSS sg13cmos5l_fill_2
Xfeedback_divider_i._329_ feedback_divider_i._329_/Y feedback_divider_i._595_/Q feedback_divider_i._580_/Q
+ feedback_divider_i._594_/Q feedback_divider_i._579_/Q VDD VSS sg13cmos5l_a22oi_1
XFILLER_23_67 VDD VSS sg13cmos5l_decap_8
XFILLER_23_78 VDD VSS sg13cmos5l_decap_8
XFILLER_2_157 VDD VSS sg13cmos5l_decap_4
XFILLER_2_168 VDD VSS sg13cmos5l_fill_2
Xfeedback_divider_i.configuration_decode_i._121_ feedback_divider_i.configuration_decode_i._137_/D
+ fanout41/X fanout61/X VDD VSS sg13cmos5l_nor2b_1
Xfeedback_divider_i.configuration_decode_i._052_ feedback_divider_i.configuration_decode_i._052_/Y
+ fanout20/X fanout58/X fanout57/X VDD VSS sg13cmos5l_a21oi_1
Xoutput_divider_i.div2_ff pll_clk output_divider_i.div2_ff/D output_divider_i.div2_ff/CLK
+ output_divider_i.div2_ff/D output_divider_i._4_/X VDD VSS sg13cmos5l_dfrbp_2
Xfeedback_divider_i.configuration_decode_i._104_ fanout17/A fanout61/X fanout41/X
+ VDD VSS sg13cmos5l_nand2b_1
Xfeedback_divider_i._594_ feedback_divider_i._594_/Q clkbuf_4_6_0_pll_clk_regs/X feedback_divider_i._594_/D
+ fanout25/X VDD VSS sg13cmos5l_dfrbpq_2
XFILLER_1_92 VDD VSS sg13cmos5l_decap_4
XFILLER_27_0 VDD VSS sg13cmos5l_decap_8
Xoutput_divider_i.vco_input_buffer.output_inverter_73 output_divider_i.div2_ff/CLK
+ output_divider_i.vco_input_buffer.input_inverter_72/Y VDD VSS sg13cmos5l_inv_16
Xfeedback_divider_i._577_ feedback_divider_i._577_/Q clkbuf_4_6_0_pll_clk_regs/X feedback_divider_i._580_/D
+ fanout27/X VDD VSS sg13cmos5l_dfrbpq_2
XFILLER_0_244 VDD VSS sg13cmos5l_fill_2
XFILLER_25_123 VDD VSS sg13cmos5l_fill_1
XFILLER_25_189 VDD VSS sg13cmos5l_fill_2
Xfeedback_divider_i._500_ feedback_divider_i._500_/Q feedback_divider_i._561_/CLK
+ feedback_divider_i._504_/D fanout35/X VDD VSS sg13cmos5l_dfrbpq_2
Xfeedback_divider_i._431_ feedback_divider_i._532_/D feedback_divider_i._495_/Q feedback_divider_i._298_/Y
+ feedback_divider_i._430_/Y VDD VSS sg13cmos5l_o21ai_1
XFILLER_16_189 VDD VSS sg13cmos5l_decap_8
Xfeedback_divider_i._293_ feedback_divider_i._293_/Y feedback_divider_i._293_/A VDD
+ VSS sg13cmos5l_inv_2
Xfeedback_divider_i._362_ feedback_divider_i._362_/Y feedback_divider_i._504_/Q feedback_divider_i._263_/A
+ feedback_divider_i._565_/Q VDD VSS sg13cmos5l_a21oi_1
XFILLER_13_115 VDD VSS sg13cmos5l_decap_4
XFILLER_26_78 VDD VSS sg13cmos5l_fill_2
XFILLER_21_170 VDD VSS sg13cmos5l_decap_4
Xfeedback_divider_i._276_ feedback_divider_i._276_/Y feedback_divider_i._276_/A VDD
+ VSS sg13cmos5l_inv_2
Xfeedback_divider_i._345_ feedback_divider_i._345_/Y feedback_divider_i._587_/Q feedback_divider_i._574_/Q
+ feedback_divider_i._586_/Q feedback_divider_i._573_/Q VDD VSS sg13cmos5l_a22oi_1
Xfeedback_divider_i._414_ feedback_divider_i._414_/Y feedback_divider_i._498_/Q feedback_divider_i._289_/A
+ feedback_divider_i._539_/Q VDD VSS sg13cmos5l_a21oi_1
XFILLER_12_181 VDD VSS sg13cmos5l_fill_1
XFILLER_8_163 VDD VSS sg13cmos5l_decap_8
Xclkbuf_0_pll_clk clkbuf_0_pll_clk/X pll_clk VDD VSS sg13cmos5l_buf_16
XFILLER_18_207 VDD VSS sg13cmos5l_fill_1
XFILLER_5_111 VDD VSS sg13cmos5l_decap_8
XFILLER_17_262 VDD VSS sg13cmos5l_decap_8
Xfeedback_divider_i._259_ feedback_divider_i._259_/Y feedback_divider_i._259_/A VDD
+ VSS sg13cmos5l_inv_2
Xfeedback_divider_i._328_ feedback_divider_i._596_/D feedback_divider_i._578_/Q feedback_divider_i._246_/Y
+ feedback_divider_i._327_/Y VDD VSS sg13cmos5l_o21ai_1
XFILLER_23_46 VDD VSS sg13cmos5l_decap_8
XFILLER_2_125 VDD VSS sg13cmos5l_fill_1
XFILLER_4_92 VDD VSS sg13cmos5l_decap_8
Xfeedback_divider_i.configuration_decode_i._120_ feedback_divider_i._292_/A feedback_divider_i.configuration_decode_i._156_/A
+ fanout16/X VDD VSS sg13cmos5l_nor2_1
Xfeedback_divider_i.configuration_decode_i._051_ feedback_divider_i.configuration_decode_i._051_/Y
+ fanout20/X fanout58/X VDD VSS sg13cmos5l_nand2_1
XFILLER_0_28 VDD VSS sg13cmos5l_decap_8
XFILLER_14_287 VDD VSS sg13cmos5l_decap_8
XFILLER_18_57 VDD VSS sg13cmos5l_fill_1
XFILLER_11_202 VDD VSS sg13cmos5l_fill_2
Xclkload0 clkload0/X clkload0/A VDD VSS sg13cmos5l_buf_2
Xfeedback_divider_i.configuration_decode_i._103_ feedback_divider_i.configuration_decode_i._119_/D
+ fanout60/X fanout40/X VDD VSS sg13cmos5l_nor2b_1
Xfeedback_divider_i._593_ feedback_divider_i._593_/Q clkbuf_4_5_0_pll_clk_regs/X feedback_divider_i._593_/D
+ fanout26/X VDD VSS sg13cmos5l_dfrbpq_2
XFILLER_6_261 VDD VSS sg13cmos5l_decap_8
XFILLER_6_272 VDD VSS sg13cmos5l_fill_1
XFILLER_28_187 VDD VSS sg13cmos5l_fill_2
XFILLER_13_7 VDD VSS sg13cmos5l_decap_8
XFILLER_19_110 VDD VSS sg13cmos5l_decap_4
XFILLER_6_49 VDD VSS sg13cmos5l_fill_1
Xfeedback_divider_i._576_ feedback_divider_i._576_/Q clkbuf_4_6_0_pll_clk_regs/X feedback_divider_i._579_/D
+ fanout27/X VDD VSS sg13cmos5l_dfrbpq_2
XFILLER_13_308 VDD VSS sg13cmos5l_fill_1
XFILLER_15_58 VDD VSS sg13cmos5l_decap_4
XFILLER_25_146 VDD VSS sg13cmos5l_decap_8
Xclkbuf_0_output_divider_i.div8_clk clkbuf_0_output_divider_i.div8_clk/X clkbuf_regs_2_div8/A
+ VDD VSS sg13cmos5l_buf_16
Xclkbuf_1_0_0_pll_clk_regs clkbuf_2_1_0_pll_clk_regs/A clkbuf_0_pll_clk_regs/X VDD
+ VSS sg13cmos5l_buf_8
Xoutput_divider_i.div8_ff clkbuf_regs_2_div8/A output_divider_i.div8_ff/D output_divider_i.div8_ff/CLK
+ output_divider_i.div8_ff/D output_divider_i._4_/X VDD VSS sg13cmos5l_dfrbp_2
XFILLER_0_223 VDD VSS sg13cmos5l_decap_8
XFILLER_8_301 VDD VSS sg13cmos5l_decap_8
Xfeedback_divider_i._292_ feedback_divider_i._292_/Y feedback_divider_i._292_/A VDD
+ VSS sg13cmos5l_inv_2
Xfeedback_divider_i._430_ feedback_divider_i._430_/Y feedback_divider_i._496_/Q feedback_divider_i._297_/A
+ feedback_divider_i._531_/Q VDD VSS sg13cmos5l_a21oi_1
Xfeedback_divider_i._361_ feedback_divider_i._567_/D feedback_divider_i._503_/Q feedback_divider_i._263_/Y
+ feedback_divider_i._360_/Y VDD VSS sg13cmos5l_o21ai_1
Xfeedback_divider_i._559_ feedback_divider_i._559_/Q clkbuf_4_6_0_pll_clk_regs/X feedback_divider_i._559_/D
+ fanout27/X VDD VSS sg13cmos5l_dfrbpq_2
XFILLER_26_46 VDD VSS sg13cmos5l_fill_1
Xclkbuf_0_pll_clk_regs clkbuf_0_pll_clk_regs/X clkbuf_regs_0_half/X VDD VSS sg13cmos5l_buf_16
Xfeedback_divider_i._344_ feedback_divider_i._588_/D feedback_divider_i._572_/Q feedback_divider_i._254_/Y
+ feedback_divider_i._343_/Y VDD VSS sg13cmos5l_o21ai_1
Xfeedback_divider_i._413_ feedback_divider_i._541_/D feedback_divider_i._497_/Q feedback_divider_i._289_/Y
+ feedback_divider_i._412_/Y VDD VSS sg13cmos5l_o21ai_1
XFILLER_8_120 VDD VSS sg13cmos5l_fill_1
Xfeedback_divider_i._275_ feedback_divider_i._275_/Y feedback_divider_i._275_/A VDD
+ VSS sg13cmos5l_inv_2
XFILLER_12_48 VDD VSS sg13cmos5l_decap_8
XFILLER_26_230 VDD VSS sg13cmos5l_decap_4
Xclkbuf_3_3_0_pll_clk_regs clkbuf_4_7_0_pll_clk_regs/A clkbuf_3_3_0_pll_clk_regs/A
+ VDD VSS sg13cmos5l_buf_8
XFILLER_17_252 VDD VSS sg13cmos5l_decap_4
XFILLER_5_189 VDD VSS sg13cmos5l_fill_1
Xclkbuf_1_0_0_output_divider_i.div4_clk_regs output_divider_i.div8_ff/CLK clkbuf_0_output_divider_i.div4_clk_regs/X
+ VDD VSS sg13cmos5l_buf_8
Xfeedback_divider_i._258_ feedback_divider_i._258_/Y feedback_divider_i._258_/A VDD
+ VSS sg13cmos5l_inv_2
Xfeedback_divider_i._327_ feedback_divider_i._327_/Y feedback_divider_i._579_/Q feedback_divider_i._595_/Q
+ feedback_divider_i._580_/Q feedback_divider_i._596_/Q VDD VSS sg13cmos5l_a22oi_1
XFILLER_23_233 VDD VSS sg13cmos5l_fill_2
Xfeedback_divider_i.configuration_decode_i._050_ feedback_divider_i._248_/A feedback_divider_i.configuration_decode_i._041_/Y
+ fanout20/X feedback_divider_i.configuration_decode_i._044_/A feedback_divider_i.configuration_decode_i._049_/Y
+ VDD VSS sg13cmos5l_a22oi_1
XFILLER_14_266 VDD VSS sg13cmos5l_decap_8
XFILLER_9_49 VDD VSS sg13cmos5l_decap_8
XFILLER_20_203 VDD VSS sg13cmos5l_fill_1
XFILLER_20_236 VDD VSS sg13cmos5l_fill_1
XFILLER_20_247 VDD VSS sg13cmos5l_fill_2
XFILLER_9_281 VDD VSS sg13cmos5l_fill_2
Xclkload1 clkload1/X clkload1/A VDD VSS sg13cmos5l_buf_2
Xfeedback_divider_i.configuration_decode_i._102_ feedback_divider_i._276_/A fanout60/X
+ fanout40/X feedback_divider_i.configuration_decode_i._156_/A VDD VSS sg13cmos5l_nor3_1
Xfeedback_divider_i._592_ feedback_divider_i._592_/Q clkload0/A feedback_divider_i._592_/D
+ fanout28/X VDD VSS sg13cmos5l_dfrbpq_2
XFILLER_10_280 VDD VSS sg13cmos5l_fill_1
XFILLER_28_100 VDD VSS sg13cmos5l_decap_8
XFILLER_28_133 VDD VSS sg13cmos5l_decap_4
XFILLER_28_199 VDD VSS sg13cmos5l_decap_8
Xfeedback_divider_i._575_ feedback_divider_i._575_/Q clkload0/A feedback_divider_i._575_/D
+ fanout27/X VDD VSS sg13cmos5l_dfrbpq_2
XFILLER_16_147 VDD VSS sg13cmos5l_fill_2
Xfeedback_divider_i._291_ feedback_divider_i._291_/Y feedback_divider_i._291_/A VDD
+ VSS sg13cmos5l_inv_2
Xfeedback_divider_i._360_ feedback_divider_i._360_/Y feedback_divider_i._262_/A feedback_divider_i._504_/Q
+ feedback_divider_i._566_/Q VDD VSS sg13cmos5l_a21oi_1
XFILLER_22_106 VDD VSS sg13cmos5l_decap_8
XFILLER_22_117 VDD VSS sg13cmos5l_fill_1
Xfeedback_divider_i._558_ feedback_divider_i._558_/Q clkbuf_4_6_0_pll_clk_regs/X feedback_divider_i._558_/D
+ fanout27/X VDD VSS sg13cmos5l_dfrbpq_2
Xfeedback_divider_i._489_ feedback_divider_i._489_/Q clkbuf_4_1_0_pll_clk_regs/X feedback_divider_i._503_/D
+ fanout21/X VDD VSS sg13cmos5l_dfrbpq_2
Xfeedback_divider_i._412_ feedback_divider_i._412_/Y feedback_divider_i._498_/Q feedback_divider_i._288_/A
+ feedback_divider_i._540_/Q VDD VSS sg13cmos5l_a21oi_1
XFILLER_12_194 VDD VSS sg13cmos5l_decap_8
XFILLER_8_143 VDD VSS sg13cmos5l_decap_4
XFILLER_8_187 VDD VSS sg13cmos5l_decap_8
Xfeedback_divider_i._274_ feedback_divider_i._274_/Y feedback_divider_i._274_/A VDD
+ VSS sg13cmos5l_inv_2
Xfeedback_divider_i._343_ feedback_divider_i._343_/Y feedback_divider_i._573_/Q feedback_divider_i._587_/Q
+ feedback_divider_i._574_/Q feedback_divider_i._588_/Q VDD VSS sg13cmos5l_a22oi_1
Xfeedback_divider_i._257_ feedback_divider_i._257_/Y feedback_divider_i._257_/A VDD
+ VSS sg13cmos5l_inv_2
Xfeedback_divider_i._326_ feedback_divider_i._580_/D feedback_divider_i._579_/D VDD
+ VSS sg13cmos5l_inv_2
XFILLER_13_92 VDD VSS sg13cmos5l_decap_4
XFILLER_2_138 VDD VSS sg13cmos5l_decap_8
XFILLER_3_7 VDD VSS sg13cmos5l_decap_8
XFILLER_9_28 VDD VSS sg13cmos5l_decap_8
Xfanout60 fanout60/X fanout61/X VDD VSS sg13cmos5l_buf_1
Xfeedback_divider_i._309_ feedback_divider_i._309_/Y feedback_divider_i._309_/A VDD
+ VSS sg13cmos5l_inv_2
Xfeedback_divider_i.configuration_decode_i._101_ feedback_divider_i.configuration_decode_i._156_/A
+ fanout55/X fanout53/X fanout42/X fanout48/X VDD VSS sg13cmos5l_nand4_1
Xfeedback_divider_i._591_ feedback_divider_i._591_/Q clkload0/A feedback_divider_i._591_/D
+ fanout28/X VDD VSS sg13cmos5l_dfrbpq_2
XFILLER_19_304 VDD VSS sg13cmos5l_decap_4
XFILLER_24_91 VDD VSS sg13cmos5l_decap_8
XFILLER_6_241 VDD VSS sg13cmos5l_decap_8
XFILLER_1_51 VDD VSS sg13cmos5l_decap_4
XFILLER_28_112 VDD VSS sg13cmos5l_fill_2
XFILLER_28_145 VDD VSS sg13cmos5l_decap_8
XFILLER_28_156 VDD VSS sg13cmos5l_decap_8
XFILLER_19_145 VDD VSS sg13cmos5l_decap_8
XFILLER_19_167 VDD VSS sg13cmos5l_fill_1
XFILLER_19_178 VDD VSS sg13cmos5l_fill_1
XFILLER_28_178 VDD VSS sg13cmos5l_fill_1
XFILLER_28_189 VDD VSS sg13cmos5l_fill_1
XFILLER_3_233 VDD VSS sg13cmos5l_decap_8
XFILLER_3_255 VDD VSS sg13cmos5l_decap_8
Xfeedback_divider_i._574_ feedback_divider_i._574_/Q feedback_divider_i._588_/CLK
+ feedback_divider_i._580_/D fanout36/X VDD VSS sg13cmos5l_dfrbpq_2
XFILLER_25_0 VDD VSS sg13cmos5l_fill_1
XFILLER_0_258 VDD VSS sg13cmos5l_decap_8
Xfeedback_divider_i._290_ feedback_divider_i._290_/Y feedback_divider_i._290_/A VDD
+ VSS sg13cmos5l_inv_2
XFILLER_15_192 VDD VSS sg13cmos5l_decap_8
XFILLER_7_50 VDD VSS sg13cmos5l_decap_4
Xfeedback_divider_i._557_ feedback_divider_i._557_/Q clkbuf_4_3_0_pll_clk_regs/X feedback_divider_i._557_/D
+ fanout25/X VDD VSS sg13cmos5l_dfrbpq_2
Xfeedback_divider_i._488_ feedback_divider_i._504_/D feedback_divider_i._596_/Q feedback_divider_i._579_/D
+ VDD VSS sg13cmos5l_and2_2
XFILLER_21_184 VDD VSS sg13cmos5l_fill_2
XFILLER_26_37 VDD VSS sg13cmos5l_decap_8
XFILLER_8_177 VDD VSS sg13cmos5l_decap_4
Xfeedback_divider_i._273_ feedback_divider_i._273_/Y feedback_divider_i._273_/A VDD
+ VSS sg13cmos5l_inv_2
Xfeedback_divider_i._342_ feedback_divider_i._589_/D feedback_divider_i._575_/Q feedback_divider_i._253_/Y
+ feedback_divider_i._341_/Y VDD VSS sg13cmos5l_o21ai_1
Xfeedback_divider_i._411_ feedback_divider_i._542_/D feedback_divider_i._497_/Q feedback_divider_i._288_/Y
+ feedback_divider_i._410_/Y VDD VSS sg13cmos5l_o21ai_1
XFILLER_5_125 VDD VSS sg13cmos5l_decap_8
Xfeedback_divider_i._325_ feedback_divider_i._325_/Y feedback_divider_i._325_/A VDD
+ VSS sg13cmos5l_inv_2
Xfeedback_divider_i._256_ feedback_divider_i._256_/Y feedback_divider_i._256_/A VDD
+ VSS sg13cmos5l_inv_2
XFILLER_14_202 VDD VSS sg13cmos5l_fill_2
XFILLER_2_106 VDD VSS sg13cmos5l_decap_4
XFILLER_13_71 VDD VSS sg13cmos5l_decap_8
Xfanout50 fanout50/X input7/X VDD VSS sg13cmos5l_buf_1
Xfanout61 fanout61/X input10/X VDD VSS sg13cmos5l_buf_1
Xfeedback_divider_i._308_ feedback_divider_i._308_/Y feedback_divider_i._308_/A VDD
+ VSS sg13cmos5l_inv_2
XFILLER_11_249 VDD VSS sg13cmos5l_decap_4
XFILLER_9_283 VDD VSS sg13cmos5l_fill_1
XFILLER_9_294 VDD VSS sg13cmos5l_decap_8
Xfeedback_divider_i.configuration_decode_i._100_ feedback_divider_i._275_/A fanout42/X
+ fanout48/X feedback_divider_i.configuration_decode_i._100_/C feedback_divider_i.configuration_decode_i._155_/C
+ VDD VSS sg13cmos5l_and4_1
XFILLER_24_70 VDD VSS sg13cmos5l_decap_8
Xfeedback_divider_i._325__65 feedback_divider_i._325_/A VDD VSS sg13cmos5l_tielo
Xfeedback_divider_i._590_ feedback_divider_i._590_/Q clkload0/A feedback_divider_i._590_/D
+ fanout28/X VDD VSS sg13cmos5l_dfrbpq_2
XFILLER_1_85 VDD VSS sg13cmos5l_decap_8
XFILLER_10_83 VDD VSS sg13cmos5l_decap_8
XFILLER_16_308 VDD VSS sg13cmos5l_fill_1
Xfeedback_divider_i._573_ feedback_divider_i._573_/Q feedback_divider_i._588_/CLK
+ feedback_divider_i._579_/D fanout36/X VDD VSS sg13cmos5l_dfrbpq_2
XFILLER_18_0 VDD VSS sg13cmos5l_decap_4
XFILLER_0_237 VDD VSS sg13cmos5l_decap_8
XFILLER_16_116 VDD VSS sg13cmos5l_fill_2
XFILLER_16_149 VDD VSS sg13cmos5l_fill_1
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
