bhagwat-rahul/sg13cmos5l_rahulbhagwat_ip_pll_fractional_n_charge_pump_ring_osc/macros/pll_digital/frozen/v1/nl/pll_digital.nl.v

module pll_digital (down,
    enable,
    feedback_clk,
    pll_clk,
    ref_clk,
    reset_n,
    test_clk,
    up,
    vco_clk,
    div_ratio,
    test_div_select);
 output down;
 input enable;
 output feedback_clk;
 output pll_clk;
 input ref_clk;
 input reset_n;
 output test_clk;
 output up;
 input vco_clk;
 input [9:0] div_ratio;
 input [1:0] test_div_select;

 wire _0_;
 wire net1;
 wire net2;
 wire net3;
 wire net4;
 wire net5;
 wire net6;
 wire net7;
 wire net8;
 wire net9;
 wire net10;
 wire \feedback_divider_i._000_ ;
 wire \feedback_divider_i._001_ ;
 wire \feedback_divider_i._002_ ;
 wire \feedback_divider_i._003_ ;
 wire \feedback_divider_i._004_ ;
 wire \feedback_divider_i._005_ ;
 wire \feedback_divider_i._006_ ;
 wire \feedback_divider_i._007_ ;
 wire \feedback_divider_i._008_ ;
 wire \feedback_divider_i._009_ ;
 wire \feedback_divider_i._010_ ;
 wire \feedback_divider_i._011_ ;
 wire \feedback_divider_i._012_ ;
 wire \feedback_divider_i._013_ ;
 wire \feedback_divider_i._014_ ;
 wire \feedback_divider_i._015_ ;
 wire \feedback_divider_i._016_ ;
 wire \feedback_divider_i._017_ ;
 wire \feedback_divider_i._018_ ;
 wire \feedback_divider_i._019_ ;
 wire \feedback_divider_i._020_ ;
 wire \feedback_divider_i._021_ ;
 wire \feedback_divider_i._022_ ;
 wire \feedback_divider_i._023_ ;
 wire \feedback_divider_i._024_ ;
 wire \feedback_divider_i._025_ ;
 wire \feedback_divider_i._026_ ;
 wire \feedback_divider_i._027_ ;
 wire \feedback_divider_i._028_ ;
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
 sg13cmos5l_inv_2 \feedback_divider_i._322_  (.Y(\feedback_divider_i._159_ ),
    .A(\feedback_divider_i.base_countdown[60] ));
 sg13cmos5l_inv_2 \feedback_divider_i._323_  (.Y(\feedback_divider_i._160_ ),
    .A(\feedback_divider_i.base_countdown[61] ));
 sg13cmos5l_inv_2 \feedback_divider_i._324_  (.Y(\feedback_divider_i._161_ ),
    .A(\feedback_divider_i.base_countdown[62] ));
 sg13cmos5l_inv_2 \feedback_divider_i._325_  (.Y(\feedback_divider_i._162_ ),
    .A(net64));
 sg13cmos5l_tielo \feedback_divider_i._325__65  (.L_LO(net64));
 sg13cmos5l_inv_2 \feedback_divider_i._326_  (.Y(\feedback_divider_i._065_ ),
    .A(\feedback_divider_i.countdown[1] ));
 sg13cmos5l_a22oi_1 \feedback_divider_i._327_  (.Y(\feedback_divider_i._163_ ),
    .B1(\feedback_divider_i.fraction_hold[0] ),
    .B2(\feedback_divider_i.fraction_pattern[0] ),
    .A2(\feedback_divider_i.fraction_pattern[1] ),
    .A1(\feedback_divider_i.fraction_advance[0] ));
 sg13cmos5l_o21ai_1 \feedback_divider_i._328_  (.B1(\feedback_divider_i._163_ ),
    .Y(\feedback_divider_i._066_ ),
    .A1(\feedback_divider_i.fraction_initialized[0] ),
    .A2(\feedback_divider_i._083_ ));
 sg13cmos5l_a22oi_1 \feedback_divider_i._329_  (.Y(\feedback_divider_i._164_ ),
    .B1(\feedback_divider_i.fraction_pattern[2] ),
    .B2(\feedback_divider_i.fraction_advance[0] ),
    .A2(\feedback_divider_i.fraction_hold[0] ),
    .A1(\feedback_divider_i.fraction_pattern[1] ));
 sg13cmos5l_o21ai_1 \feedback_divider_i._330_  (.B1(\feedback_divider_i._164_ ),
    .Y(\feedback_divider_i._073_ ),
    .A1(\feedback_divider_i.fraction_initialized[0] ),
    .A2(\feedback_divider_i._084_ ));
 sg13cmos5l_a22oi_1 \feedback_divider_i._331_  (.Y(\feedback_divider_i._165_ ),
    .B1(\feedback_divider_i.fraction_pattern[3] ),
    .B2(\feedback_divider_i.fraction_advance[0] ),
    .A2(\feedback_divider_i.fraction_pattern[2] ),
    .A1(\feedback_divider_i.fraction_hold[0] ));
 sg13cmos5l_o21ai_1 \feedback_divider_i._332_  (.B1(\feedback_divider_i._165_ ),
    .Y(\feedback_divider_i._074_ ),
    .A1(\feedback_divider_i.fraction_initialized[0] ),
    .A2(\feedback_divider_i._085_ ));
 sg13cmos5l_a22oi_1 \feedback_divider_i._333_  (.Y(\feedback_divider_i._166_ ),
    .B1(\feedback_divider_i.fraction_pattern[4] ),
    .B2(\feedback_divider_i.fraction_advance[0] ),
    .A2(\feedback_divider_i.fraction_pattern[3] ),
    .A1(\feedback_divider_i.fraction_hold[0] ));
 sg13cmos5l_o21ai_1 \feedback_divider_i._334_  (.B1(\feedback_divider_i._166_ ),
    .Y(\feedback_divider_i._075_ ),
    .A1(\feedback_divider_i.fraction_initialized[0] ),
    .A2(\feedback_divider_i._086_ ));
 sg13cmos5l_a22oi_1 \feedback_divider_i._335_  (.Y(\feedback_divider_i._167_ ),
    .B1(\feedback_divider_i.fraction_hold[1] ),
    .B2(\feedback_divider_i.fraction_pattern[4] ),
    .A2(\feedback_divider_i.fraction_pattern[5] ),
    .A1(\feedback_divider_i.fraction_advance[1] ));
 sg13cmos5l_o21ai_1 \feedback_divider_i._336_  (.B1(\feedback_divider_i._167_ ),
    .Y(\feedback_divider_i._076_ ),
    .A1(\feedback_divider_i.fraction_initialized[1] ),
    .A2(\feedback_divider_i._087_ ));
 sg13cmos5l_a22oi_1 \feedback_divider_i._337_  (.Y(\feedback_divider_i._168_ ),
    .B1(\feedback_divider_i.fraction_pattern[6] ),
    .B2(\feedback_divider_i.fraction_advance[1] ),
    .A2(\feedback_divider_i.fraction_hold[1] ),
    .A1(\feedback_divider_i.fraction_pattern[5] ));
 sg13cmos5l_o21ai_1 \feedback_divider_i._338_  (.B1(\feedback_divider_i._168_ ),
    .Y(\feedback_divider_i._077_ ),
    .A1(\feedback_divider_i.fraction_initialized[1] ),
    .A2(\feedback_divider_i._088_ ));
 sg13cmos5l_a22oi_1 \feedback_divider_i._339_  (.Y(\feedback_divider_i._169_ ),
    .B1(\feedback_divider_i.fraction_pattern[7] ),
    .B2(\feedback_divider_i.fraction_advance[1] ),
    .A2(\feedback_divider_i.fraction_pattern[6] ),
    .A1(\feedback_divider_i.fraction_hold[1] ));
 sg13cmos5l_o21ai_1 \feedback_divider_i._340_  (.B1(\feedback_divider_i._169_ ),
    .Y(\feedback_divider_i._078_ ),
    .A1(\feedback_divider_i.fraction_initialized[1] ),
    .A2(\feedback_divider_i._089_ ));
 sg13cmos5l_a22oi_1 \feedback_divider_i._341_  (.Y(\feedback_divider_i._170_ ),
    .B1(\feedback_divider_i.fraction_pattern[8] ),
    .B2(\feedback_divider_i.fraction_advance[1] ),
    .A2(\feedback_divider_i.fraction_pattern[7] ),
    .A1(\feedback_divider_i.fraction_hold[1] ));
 sg13cmos5l_o21ai_1 \feedback_divider_i._342_  (.B1(\feedback_divider_i._170_ ),
    .Y(\feedback_divider_i._079_ ),
    .A1(\feedback_divider_i.fraction_initialized[1] ),
    .A2(\feedback_divider_i._090_ ));
 sg13cmos5l_a22oi_1 \feedback_divider_i._343_  (.Y(\feedback_divider_i._171_ ),
    .B1(\feedback_divider_i.fraction_hold[2] ),
    .B2(\feedback_divider_i.fraction_pattern[8] ),
    .A2(\feedback_divider_i.fraction_pattern[9] ),
    .A1(\feedback_divider_i.fraction_advance[2] ));
 sg13cmos5l_o21ai_1 \feedback_divider_i._344_  (.B1(\feedback_divider_i._171_ ),
    .Y(\feedback_divider_i._080_ ),
    .A1(\feedback_divider_i.fraction_initialized[2] ),
    .A2(\feedback_divider_i._091_ ));
 sg13cmos5l_a22oi_1 \feedback_divider_i._345_  (.Y(\feedback_divider_i._172_ ),
    .B1(\feedback_divider_i.fraction_pattern[10] ),
    .B2(\feedback_divider_i.fraction_advance[2] ),
    .A2(\feedback_divider_i.fraction_hold[2] ),
    .A1(\feedback_divider_i.fraction_pattern[9] ));
 sg13cmos5l_o21ai_1 \feedback_divider_i._346_  (.B1(\feedback_divider_i._172_ ),
    .Y(\feedback_divider_i._081_ ),
    .A1(\feedback_divider_i.fraction_initialized[2] ),
    .A2(\feedback_divider_i._092_ ));
 sg13cmos5l_a22oi_1 \feedback_divider_i._347_  (.Y(\feedback_divider_i._173_ ),
    .B1(\feedback_divider_i.fraction_pattern[11] ),
    .B2(\feedback_divider_i.fraction_advance[2] ),
    .A2(\feedback_divider_i.fraction_pattern[10] ),
    .A1(\feedback_divider_i.fraction_hold[2] ));
 sg13cmos5l_o21ai_1 \feedback_divider_i._348_  (.B1(\feedback_divider_i._173_ ),
    .Y(\feedback_divider_i._067_ ),
    .A1(\feedback_divider_i.fraction_initialized[2] ),
    .A2(\feedback_divider_i._093_ ));
 sg13cmos5l_a22oi_1 \feedback_divider_i._349_  (.Y(\feedback_divider_i._174_ ),
    .B1(\feedback_divider_i.fraction_pattern[12] ),
    .B2(\feedback_divider_i.fraction_advance[2] ),
    .A2(\feedback_divider_i.fraction_pattern[11] ),
    .A1(\feedback_divider_i.fraction_hold[2] ));
 sg13cmos5l_o21ai_1 \feedback_divider_i._350_  (.B1(\feedback_divider_i._174_ ),
    .Y(\feedback_divider_i._068_ ),
    .A1(\feedback_divider_i.fraction_initialized[2] ),
    .A2(\feedback_divider_i._094_ ));
 sg13cmos5l_a22oi_1 \feedback_divider_i._351_  (.Y(\feedback_divider_i._175_ ),
    .B1(\feedback_divider_i.fraction_hold[3] ),
    .B2(\feedback_divider_i.fraction_pattern[12] ),
    .A2(\feedback_divider_i.fraction_pattern[13] ),
    .A1(\feedback_divider_i.fraction_advance[3] ));
 sg13cmos5l_o21ai_1 \feedback_divider_i._352_  (.B1(\feedback_divider_i._175_ ),
    .Y(\feedback_divider_i._069_ ),
    .A1(\feedback_divider_i.fraction_initialized[3] ),
    .A2(\feedback_divider_i._095_ ));
 sg13cmos5l_a22oi_1 \feedback_divider_i._353_  (.Y(\feedback_divider_i._176_ ),
    .B1(\feedback_divider_i.fraction_pattern[14] ),
    .B2(\feedback_divider_i.fraction_advance[3] ),
    .A2(\feedback_divider_i.fraction_hold[3] ),
    .A1(\feedback_divider_i.fraction_pattern[13] ));
 sg13cmos5l_o21ai_1 \feedback_divider_i._354_  (.B1(\feedback_divider_i._176_ ),
    .Y(\feedback_divider_i._070_ ),
    .A1(\feedback_divider_i.fraction_initialized[3] ),
    .A2(\feedback_divider_i._096_ ));
 sg13cmos5l_a22oi_1 \feedback_divider_i._355_  (.Y(\feedback_divider_i._177_ ),
    .B1(\feedback_divider_i.fraction_pattern[15] ),
    .B2(\feedback_divider_i.fraction_advance[3] ),
    .A2(\feedback_divider_i.fraction_pattern[14] ),
    .A1(\feedback_divider_i.fraction_hold[3] ));
 sg13cmos5l_o21ai_1 \feedback_divider_i._356_  (.B1(\feedback_divider_i._177_ ),
    .Y(\feedback_divider_i._071_ ),
    .A1(\feedback_divider_i.fraction_initialized[3] ),
    .A2(\feedback_divider_i._097_ ));
 sg13cmos5l_a22oi_1 \feedback_divider_i._357_  (.Y(\feedback_divider_i._178_ ),
    .B1(\feedback_divider_i.fraction_hold[3] ),
    .B2(\feedback_divider_i.fraction_pattern[15] ),
    .A2(\feedback_divider_i.fraction_advance[3] ),
    .A1(\feedback_divider_i.fraction_pattern[0] ));
 sg13cmos5l_o21ai_1 \feedback_divider_i._358_  (.B1(\feedback_divider_i._178_ ),
    .Y(\feedback_divider_i._072_ ),
    .A1(\feedback_divider_i.fraction_initialized[3] ),
    .A2(\feedback_divider_i._098_ ));
 sg13cmos5l_o21ai_1 \feedback_divider_i._359_  (.B1(\feedback_divider_i._065_ ),
    .Y(\feedback_divider_i._001_ ),
    .A1(\feedback_divider_i.base_reload_idle[0] ),
    .A2(\feedback_divider_i._099_ ));
 sg13cmos5l_a21oi_1 \feedback_divider_i._360_  (.A1(\feedback_divider_i.base_countdown[0] ),
    .A2(\feedback_divider_i.reload_plus_pending[0] ),
    .Y(\feedback_divider_i._179_ ),
    .B1(\feedback_divider_i.countdown[2] ));
 sg13cmos5l_o21ai_1 \feedback_divider_i._361_  (.B1(\feedback_divider_i._179_ ),
    .Y(\feedback_divider_i._012_ ),
    .A1(\feedback_divider_i.base_reload_idle[0] ),
    .A2(\feedback_divider_i._100_ ));
 sg13cmos5l_a21oi_1 \feedback_divider_i._362_  (.A1(\feedback_divider_i.reload_plus_pending[0] ),
    .A2(\feedback_divider_i.base_countdown[1] ),
    .Y(\feedback_divider_i._180_ ),
    .B1(\feedback_divider_i.countdown[3] ));
 sg13cmos5l_o21ai_1 \feedback_divider_i._363_  (.B1(\feedback_divider_i._180_ ),
    .Y(\feedback_divider_i._023_ ),
    .A1(\feedback_divider_i.base_reload_idle[0] ),
    .A2(\feedback_divider_i._101_ ));
 sg13cmos5l_a21oi_1 \feedback_divider_i._364_  (.A1(\feedback_divider_i.reload_plus_pending[0] ),
    .A2(\feedback_divider_i.base_countdown[2] ),
    .Y(\feedback_divider_i._181_ ),
    .B1(\feedback_divider_i.countdown[4] ));
 sg13cmos5l_o21ai_1 \feedback_divider_i._365_  (.B1(\feedback_divider_i._181_ ),
    .Y(\feedback_divider_i._034_ ),
    .A1(\feedback_divider_i.base_reload_idle[0] ),
    .A2(\feedback_divider_i._102_ ));
 sg13cmos5l_a21oi_1 \feedback_divider_i._366_  (.A1(\feedback_divider_i.reload_plus_pending[0] ),
    .A2(\feedback_divider_i.base_countdown[3] ),
    .Y(\feedback_divider_i._182_ ),
    .B1(\feedback_divider_i.countdown[5] ));
 sg13cmos5l_o21ai_1 \feedback_divider_i._367_  (.B1(\feedback_divider_i._182_ ),
    .Y(\feedback_divider_i._045_ ),
    .A1(\feedback_divider_i.base_reload_idle[0] ),
    .A2(\feedback_divider_i._103_ ));
 sg13cmos5l_a21oi_1 \feedback_divider_i._368_  (.A1(\feedback_divider_i.reload_plus_pending[0] ),
    .A2(\feedback_divider_i.base_countdown[4] ),
    .Y(\feedback_divider_i._183_ ),
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
 sg13cmos5l_o21ai_1 \feedback_divider_i._483_  (.B1(\feedback_divider_i._240_ ),
    .Y(\feedback_divider_i._059_ ),
    .A1(\feedback_divider_i.base_reload_idle[7] ),
    .A2(\feedback_divider_i._161_ ));
 sg13cmos5l_nand2_1 \feedback_divider_i._484_  (.Y(\feedback_divider_i._241_ ),
    .A(\feedback_divider_i.reload_plus_pending[7] ),
    .B(\feedback_divider_i.base_countdown[62] ));
 sg13cmos5l_o21ai_1 \feedback_divider_i._485_  (.B1(\feedback_divider_i._241_ ),
    .Y(\feedback_divider_i._060_ ),
    .A1(\feedback_divider_i.base_reload_idle[7] ),
    .A2(\feedback_divider_i._162_ ));
 sg13cmos5l_nand2b_2 \feedback_divider_i._486_  (.Y(\feedback_divider_i._000_ ),
    .B(\feedback_divider_i.countdown[1] ),
    .A_N(\feedback_divider_i.fraction_pattern[0] ));
 sg13cmos5l_and2_1 \feedback_divider_i._487_  (.A(net11),
    .B(enable),
    .X(\feedback_divider_i.reset_b ));
 sg13cmos5l_and2_2 \feedback_divider_i._488_  (.A(\feedback_divider_i.fraction_pattern[0] ),
    .B(\feedback_divider_i.countdown[1] ),
    .X(\feedback_divider_i._082_ ));
 sg13cmos5l_dfrbpq_2 \feedback_divider_i._489_  (.RESET_B(net21),
    .D(\feedback_divider_i._000_ ),
    .Q(\feedback_divider_i.base_reload_idle[7] ),
    .CLK(clknet_4_1_0_pll_clk_regs));
 sg13cmos5l_dfrbpq_2 \feedback_divider_i._490_  (.RESET_B(net21),
    .D(\feedback_divider_i._082_ ),
    .Q(\feedback_divider_i.reload_plus_pending[7] ),
    .CLK(clknet_4_0_0_pll_clk_regs));
 sg13cmos5l_dfrbpq_2 \feedback_divider_i._491_  (.RESET_B(net22),
    .D(\feedback_divider_i._000_ ),
    .Q(\feedback_divider_i.base_reload_idle[6] ),
    .CLK(clknet_4_0_0_pll_clk_regs));
 sg13cmos5l_dfrbpq_2 \feedback_divider_i._492_  (.RESET_B(net22),
    .D(\feedback_divider_i._082_ ),
    .Q(\feedback_divider_i.reload_plus_pending[6] ),
    .CLK(clknet_4_0_0_pll_clk_regs));
 sg13cmos5l_dfrbpq_2 \feedback_divider_i._493_  (.RESET_B(net30),
    .D(\feedback_divider_i._000_ ),
    .Q(\feedback_divider_i.base_reload_idle[5] ),
    .CLK(clknet_4_8_0_pll_clk_regs));
 sg13cmos5l_dfrbpq_2 \feedback_divider_i._494_  (.RESET_B(net23),
    .D(\feedback_divider_i._082_ ),
    .Q(\feedback_divider_i.reload_plus_pending[5] ),
    .CLK(clknet_4_2_0_pll_clk_regs));
 sg13cmos5l_dfrbpq_2 \feedback_divider_i._495_  (.RESET_B(net30),
    .D(\feedback_divider_i._000_ ),
    .Q(\feedback_divider_i.base_reload_idle[4] ),
    .CLK(clknet_4_8_0_pll_clk_regs));
 sg13cmos5l_dfrbpq_2 \feedback_divider_i._496_  (.RESET_B(net32),
    .D(\feedback_divider_i._082_ ),
    .Q(\feedback_divider_i.reload_plus_pending[4] ),
    .CLK(clknet_4_10_0_pll_clk_regs));
 sg13cmos5l_dfrbpq_2 \feedback_divider_i._497_  (.RESET_B(net31),
    .D(\feedback_divider_i._000_ ),
    .Q(\feedback_divider_i.base_reload_idle[3] ),
    .CLK(clknet_4_3_0_pll_clk_regs));
 sg13cmos5l_dfrbpq_2 \feedback_divider_i._498_  (.RESET_B(net35),
    .D(\feedback_divider_i._082_ ),
    .Q(\feedback_divider_i.reload_plus_pending[3] ),
    .CLK(clknet_4_12_0_pll_clk_regs));
 sg13cmos5l_dfrbpq_2 \feedback_divider_i._499_  (.RESET_B(net35),
    .D(\feedback_divider_i._000_ ),
    .Q(\feedback_divider_i.base_reload_idle[2] ),
    .CLK(clknet_4_12_0_pll_clk_regs));
 sg13cmos5l_dfrbpq_2 \feedback_divider_i._500_  (.RESET_B(net35),
    .D(\feedback_divider_i._082_ ),
    .Q(\feedback_divider_i.reload_plus_pending[2] ),
    .CLK(clknet_4_12_0_pll_clk_regs));
 sg13cmos5l_dfrbpq_2 \feedback_divider_i._501_  (.RESET_B(net24),
    .D(\feedback_divider_i._000_ ),
    .Q(\feedback_divider_i.base_reload_idle[1] ),
    .CLK(clknet_4_4_0_pll_clk_regs));
 sg13cmos5l_dfrbpq_2 \feedback_divider_i._502_  (.RESET_B(net24),
    .D(\feedback_divider_i._082_ ),
    .Q(\feedback_divider_i.reload_plus_pending[1] ),
    .CLK(clknet_4_4_0_pll_clk_regs));
 sg13cmos5l_dfrbpq_2 \feedback_divider_i._503_  (.RESET_B(net35),
    .D(\feedback_divider_i._000_ ),
    .Q(\feedback_divider_i.base_reload_idle[0] ),
    .CLK(clknet_4_12_0_pll_clk_regs));
 sg13cmos5l_dfrbpq_2 \feedback_divider_i._504_  (.RESET_B(net35),
    .D(\feedback_divider_i._082_ ),
    .Q(\feedback_divider_i.reload_plus_pending[0] ),
    .CLK(clknet_4_12_0_pll_clk_regs));
 sg13cmos5l_dfrbpq_2 \feedback_divider_i._505_  (.RESET_B(net21),
    .D(\feedback_divider_i._060_ ),
    .Q(\feedback_divider_i.countdown[63] ),
    .CLK(clknet_4_1_0_pll_clk_regs));
 sg13cmos5l_dfrbpq_2 \feedback_divider_i._506_  (.RESET_B(net21),
    .D(\feedback_divider_i._059_ ),
    .Q(\feedback_divider_i.countdown[62] ),
    .CLK(clknet_4_1_0_pll_clk_regs));
 sg13cmos5l_dfrbpq_2 \feedback_divider_i._507_  (.RESET_B(net21),
    .D(\feedback_divider_i._058_ ),
    .Q(\feedback_divider_i.countdown[61] ),
    .CLK(clknet_4_1_0_pll_clk_regs));
 sg13cmos5l_dfrbpq_2 \feedback_divider_i._508_  (.RESET_B(net21),
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
 sg13cmos5l_tiehi \feedback_divider_i._575__68  (.L_HI(net67));
 sg13cmos5l_dfrbpq_2 \feedback_divider_i._576_  (.RESET_B(net27),
    .D(\feedback_divider_i.countdown[1] ),
    .Q(\feedback_divider_i.fraction_advance[1] ),
    .CLK(clknet_4_6_0_pll_clk_regs));
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
