bhagwat-rahul/sg13cmos5l_rahulbhagwat_ip_pll_fractional_n_charge_pump_ring_osc/macros/pll_digital/frozen/v1/pnl/pll_digital.pnl.v

module pll_digital (down,
    enable,
    feedback_clk,
    pll_clk,
    ref_clk,
    reset_n,
    test_clk,
    up,
    vco_clk,
    VDD,
    VSS,
    div_ratio,
    test_div_select);
 output down;
 input enable;
 output feedback_clk;
 output pll_clk;
 input ref_clk;
 input reset_n;
 output test_clk;
 output up;
 input vco_clk;
 inout VDD;
 inout VSS;
 input [9:0] div_ratio;
 input [1:0] test_div_select;

 wire _0_;
 wire net1;
 wire net2;
 wire net3;
 wire net4;
 wire net5;
 wire net6;
 wire net7;
 wire net8;
 wire net9;
 wire net10;
 wire \feedback_divider_i._000_ ;
 wire \feedback_divider_i._001_ ;
 wire \feedback_divider_i._002_ ;
 wire \feedback_divider_i._003_ ;
 wire \feedback_divider_i._004_ ;
 wire \feedback_divider_i._005_ ;
 wire \feedback_divider_i._006_ ;
 wire \feedback_divider_i._007_ ;
 wire \feedback_divider_i._008_ ;
 wire \feedback_divider_i._009_ ;
 wire \feedback_divider_i._010_ ;
 wire \feedback_divider_i._011_ ;
 wire \feedback_divider_i._012_ ;
 wire \feedback_divider_i._013_ ;
 wire \feedback_divider_i._014_ ;
 wire \feedback_divider_i._015_ ;
 wire \feedback_divider_i._016_ ;
 wire \feedback_divider_i._017_ ;
 wire \feedback_divider_i._018_ ;
 wire \feedback_divider_i._019_ ;
 wire \feedback_divider_i._020_ ;
 wire \feedback_divider_i._021_ ;
 wire \feedback_divider_i._022_ ;
 wire \feedback_divider_i._023_ ;
 wire \feedback_divider_i._024_ ;
 wire \feedback_divider_i._025_ ;
 wire \feedback_divider_i._026_ ;
 wire \feedback_divider_i._027_ ;
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
    .A2(\feedback_divider_i._141_ ));
 sg13cmos5l_a21oi_1 \feedback_divider_i._444_  (.VSS(VSS),
    .VDD(VDD),
    .A1(\feedback_divider_i.reload_plus_pending[5] ),
    .A2(\feedback_divider_i.base_countdown[42] ),
    .Y(\feedback_divider_i._221_ ),
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
