bhagwat-rahul/sg13cmos5l_rahulbhagwat_ip_pll_fractional_n_charge_pump_ring_osc/macros/pll_digital/rtl/clock_output_divider.v

`timescale 1ns/1ps

// Portable toggle stage. Synthesis can implement this with an ordinary DFF
// plus inversion; a PDK-specific technology map may replace the module with a
// complementary-output DFF without putting physical cell names in the RTL.
module async_toggle_ff (
    input  wire clk,
    input  wire reset_b,
    output reg  q
);
    always @(posedge clk or negedge reset_b) begin
        if (!reset_b)
            q <= 1'b0;
        else
            q <= ~q;
    end
endmodule

// Analog VCO edge-conditioning boundary. The standard-cell flow maps this to
// a small buffer and preserves its public instance name during timing repair.
module vco_clock_buffer (
    input wire a,
    output wire y
);
    assign y = a;
endmodule

// Portable boundary for the full-rate fixed divide-by-two stage. The current
// standard-cell flow maps this to a complementary-output DFF; a custom TSPC
// implementation remains an alternative. Simulation retains this toggle model.
module high_speed_div2 (
    input  wire clk,
    input  wire reset_b,
    output reg  q
);
    always @(posedge clk or negedge reset_b) begin
        if (!reset_b)
            q <= 1'b0;
        else
            q <= ~q;
    end
endmodule

// Portable buffering boundary between the full-rate divider and the
// half-rate CMOS clock domain. A PDK-specific technology map may replace this
// with an appropriately sized clock-capable standard-cell buffer.
module half_rate_clock_buffer (
    input  wire a,
    output wire y
);
    assign y = a;
endmodule

// Shared full-rate front end and binary test divider. pll_clk is both the
// internal half-rate clock and the clock for the feedback interval engine.
// test_div_sel selects VCO/2, /4, /8, or /16.
module clock_output_divider (
    input  wire       vco_clk,
    input  wire       reset_n,
    input  wire       enable,
    input  wire [1:0] test_div_sel,
    output wire       pll_clk,
    output reg        test_clk
);
    wire reset_b = reset_n && enable;
    wire conditioned_vco_clk;
    wire div2_raw_clk;
    wire div2_clk;
    wire div4_clk;
    wire div8_clk;
    wire div16_clk;

    // Only the first stage sees the full VCO rate. Later stages form an
    // asynchronous ripple chain.
    vco_clock_buffer vco_input_buffer (
        .a(vco_clk), .y(conditioned_vco_clk)
    );
    high_speed_div2 div2_ff (
        .clk(conditioned_vco_clk), .reset_b(reset_b), .q(div2_raw_clk)
    );
    half_rate_clock_buffer half_clk_buffer (
        .a(div2_raw_clk), .y(div2_clk)
    );
    async_toggle_ff div4_ff (
        .clk(div2_clk), .reset_b(reset_b), .q(div4_clk)
    );
    async_toggle_ff div8_ff (
        .clk(div4_clk), .reset_b(reset_b), .q(div8_clk)
    );
    async_toggle_ff div16_ff (
        .clk(div8_clk), .reset_b(reset_b), .q(div16_clk)
    );

    assign pll_clk = div2_clk;

    always @* begin
        case (test_div_sel)
            2'b00: test_clk = div2_clk;
            2'b01: test_clk = div4_clk;
            2'b10: test_clk = div8_clk;
            default: test_clk = div16_clk;
        endcase
    end
endmodule
