bhagwat-rahul/sg13cmos5l_rahulbhagwat_ip_pll_fractional_n_charge_pump_ring_osc/macros/pll_digital/flow/librelane/standardcell_div2_map.v

// Standard-cell-only alternative to the custom TSPC front end.
// Keep Q's distribution load separate from Q_N's local toggle feedback.
(* techmap_celltype = "high_speed_div2 async_toggle_ff" *)
module standardcell_toggle_map (
    input wire clk,
    input wire reset_b,
    output wire q
);
    wire q_n;
    sg13cmos5l_dfrbp_2 _TECHMAP_REPLACE_ (
        .CLK(clk),
        .RESET_B(reset_b),
        .D(q_n),
        .Q(q),
        .Q_N(q_n)
    );
endmodule

// Reduce the schematic VCO's input load while retaining a strong clock driver.
// The monolithic buf16 receiver failed the SS transistor-level VCO probe.
(* techmap_celltype = "vco_clock_buffer" *)
module standardcell_vco_clock_buffer_map (
    input wire a,
    output wire y
);
    wire inverted;
    (* keep *) sg13cmos5l_inv_4 input_inverter (.A(a), .Y(inverted));
    (* keep *) sg13cmos5l_inv_16 output_inverter (.A(inverted), .Y(y));
endmodule

(* techmap_celltype = "half_rate_clock_buffer" *)
module standardcell_half_clock_buffer_map (
    input wire a,
    output wire y
);
    sg13cmos5l_buf_16 _TECHMAP_REPLACE_ (.A(a), .X(y));
endmodule
