bhagwat-rahul/sg13cmos5l_rahulbhagwat_ip_pll_fractional_n_charge_pump_ring_osc/(commit log)

2026-10-12 begin porting design from old template repo
    [charge_pump.sch, charge_pump.tb.sch, feedback_divider.sch, feedback_divider.tb.sch, inverter.sch, inverter.tb.sch, loop_filter.sch, loop_filter.tb.sch]
2026-10-12 gen spice files of all schematics to import into magic (these are all generated so maybe dont trust them to be recent, just regen if you need to use these)
2026-10-13 new .sym's (which mess up schematics cz new ones are std sized), fixing schematics currently work in progress, finished top and charge pump, xchemrc netlists to a folder in repo when netlisting from 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
    [charge_pump.sch, pll_analog.sch, pll_cosim.sch]
2026-10-13 inverter minor edits
    [inverter.sch]
2026-10-13 vco bias and ring osc reschem
    [ring_oscillator.sch, vco_bias.sch]
2026-10-13 vco buffer reschem layout
    [vco_buffer.sch]
2026-10-14 fix more shit, remove unneeded out that went to lvds and some sch aesthetics, sim still running
    [output_divider.sch, pll.sch, pll_analog.sch, pll_cosim.sch, pll_cosim.tb.sch]
2026-10-15 PD passes all corners for digital + prescaler!!
    [pin_order.cfg]
2026-10-15 some more fixes, freezing digital block layout for now
    [pll_digital__nom_fast_1p32V_m40C.sdf, pll_digital__nom_slow_1p08V_125C.sdf, pll_digital__nom_typ_1p20V_25C.sdf]
2026-10-18 regen from cicpy
    [inverter.sch, vco_buffer.sch]
2026-10-22 package into slot
2026-10-22 dont do rewrite c (capacitor) in extres native magic flow works
2026-10-23 skip pwr gnd for kpex cz unnecessary
