bhagwat-rahul/sg13cmos5l_rahulbhagwat_ip_pll_fractional_n_charge_pump_ring_osc/(notices)

Notices in the files:
final/netlist/slot_13.spice:
Copyright 2023 IHP PDK Authors
Licensed under the Apache License, Version 2.0 (the "License");
